eshooper2008-cyber/fpga-wave-generator/src/sin.v

module sin (
    input wire [12:0] INPUT,      
    output reg [9:0] OUTPUT
);

initial OUTPUT = 10'b0000000000;  
reg [9:0] memory [0:8192];

initial begin
    memory[0] = 10'h200; memory[1] = 10'h200; memory[2] = 10'h201; memory[3] = 10'h201; memory[4] = 10'h202; memory[5] = 10'h202; memory[6] = 10'h202; memory[7] = 10'h203; memory[8] = 10'h203; memory[9] = 10'h204;
    memory[10] = 10'h204; memory[11] = 10'h204; memory[12] = 10'h205; memory[13] = 10'h205; memory[14] = 10'h205; memory[15] = 10'h206; memory[16] = 10'h206; memory[17] = 10'h207; memory[18] = 10'h207; memory[19] = 10'h207;
    memory[20] = 10'h208; memory[21] = 10'h208; memory[22] = 10'h209; memory[23] = 10'h209; memory[24] = 10'h209; memory[25] = 10'h20a; memory[26] = 10'h20a; memory[27] = 10'h20b; memory[28] = 10'h20b; memory[29] = 10'h20b;
    memory[30] = 10'h20c; memory[31] = 10'h20c; memory[32] = 10'h20d; memory[33] = 10'h20d; memory[34] = 10'h20d; memory[35] = 10'h20e; memory[36] = 10'h20e; memory[37] = 10'h20f; memory[38] = 10'h20f; memory[39] = 10'h20f;
    memory[40] = 10'h210; memory[41] = 10'h210; memory[42] = 10'h210; memory[43] = 10'h211; memory[44] = 10'h211; memory[45] = 10'h212; memory[46] = 10'h212; memory[47] = 10'h212; memory[48] = 10'h213; memory[49] = 10'h213;
    memory[50] = 10'h214; memory[51] = 10'h214; memory[52] = 10'h214; memory[53] = 10'h215; memory[54] = 10'h215; memory[55] = 10'h216; memory[56] = 10'h216; memory[57] = 10'h216; memory[58] = 10'h217; memory[59] = 10'h217;
    memory[60] = 10'h218; memory[61] = 10'h218; memory[62] = 10'h218; memory[63] = 10'h219; memory[64] = 10'h219; memory[65] = 10'h21a; memory[66] = 10'h21a; memory[67] = 10'h21a; memory[68] = 10'h21b; memory[69] = 10'h21b;
    memory[70] = 10'h21b; memory[71] = 10'h21c; memory[72] = 10'h21c; memory[73] = 10'h21d; memory[74] = 10'h21d; memory[75] = 10'h21d; memory[76] = 10'h21e; memory[77] = 10'h21e; memory[78] = 10'h21f; memory[79] = 10'h21f;
    memory[80] = 10'h21f; memory[81] = 10'h220; memory[82] = 10'h220; memory[83] = 10'h221; memory[84] = 10'h221; memory[85] = 10'h221; memory[86] = 10'h222; memory[87] = 10'h222; memory[88] = 10'h223; memory[89] = 10'h223;
    memory[90] = 10'h223; memory[91] = 10'h224; memory[92] = 10'h224; memory[93] = 10'h224; memory[94] = 10'h225; memory[95] = 10'h225; memory[96] = 10'h226; memory[97] = 10'h226; memory[98] = 10'h226; memory[99] = 10'h227;
    memory[100] = 10'h227; memory[101] = 10'h228; memory[102] = 10'h228; memory[103] = 10'h228; memory[104] = 10'h229; memory[105] = 10'h229; memory[106] = 10'h22a; memory[107] = 10'h22a; memory[108] = 10'h22a; memory[109] = 10'h22b;
    memory[110] = 10'h22b; memory[111] = 10'h22c; memory[112] = 10'h22c; memory[113] = 10'h22c; memory[114] = 10'h22d; memory[115] = 10'h22d; memory[116] = 10'h22d; memory[117] = 10'h22e; memory[118] = 10'h22e; memory[119] = 10'h22f;
    memory[120] = 10'h22f; memory[121] = 10'h22f; memory[122] = 10'h230; memory[123] = 10'h230; memory[124] = 10'h231; memory[125] = 10'h231; memory[126] = 10'h231; memory[127] = 10'h232; memory[128] = 10'h232; memory[129] = 10'h233;
    memory[130] = 10'h233; memory[131] = 10'h233; memory[132] = 10'h234; memory[133] = 10'h234; memory[134] = 10'h235; memory[135] = 10'h235; memory[136] = 10'h235; memory[137] = 10'h236; memory[138] = 10'h236; memory[139] = 10'h236;
    memory[140] = 10'h237; memory[141] = 10'h237; memory[142] = 10'h238; memory[143] = 10'h238; memory[144] = 10'h238; memory[145] = 10'h239; memory[146] = 10'h239; memory[147] = 10'h23a; memory[148] = 10'h23a; memory[149] = 10'h23a;
    memory[150] = 10'h23b; memory[151] = 10'h23b; memory[152] = 10'h23c; memory[153] = 10'h23c; memory[154] = 10'h23c; memory[155] = 10'h23d; memory[156] = 10'h23d; memory[157] = 10'h23e; memory[158] = 10'h23e; memory[159] = 10'h23e;
    memory[160] = 10'h23f; memory[161] = 10'h23f; memory[162] = 10'h23f; memory[163] = 10'h240; memory[164] = 10'h240; memory[165] = 10'h241; memory[166] = 10'h241; memory[167] = 10'h241; memory[168] = 10'h242; memory[169] = 10'h242;
    memory[170] = 10'h243; memory[171] = 10'h243; memory[172] = 10'h243; memory[173] = 10'h244; memory[174] = 10'h244; memory[175] = 10'h245; memory[176] = 10'h245; memory[177] = 10'h245; memory[178] = 10'h246; memory[179] = 10'h246;
    memory[180] = 10'h246; memory[181] = 10'h247; memory[182] = 10'h247; memory[183] = 10'h248; memory[184] = 10'h248; memory[185] = 10'h248; memory[186] = 10'h249; memory[187] = 10'h249; memory[188] = 10'h24a; memory[189] = 10'h24a;
    memory[190] = 10'h24a; memory[191] = 10'h24b; memory[192] = 10'h24b; memory[193] = 10'h24c; memory[194] = 10'h24c; memory[195] = 10'h24c; memory[196] = 10'h24d; memory[197] = 10'h24d; memory[198] = 10'h24d; memory[199] = 10'h24e;
    memory[200] = 10'h24e; memory[201] = 10'h24f; memory[202] = 10'h24f; memory[203] = 10'h24f; memory[204] = 10'h250; memory[205] = 10'h250; memory[206] = 10'h251; memory[207] = 10'h251; memory[208] = 10'h251; memory[209] = 10'h252;
    memory[210] = 10'h252; memory[211] = 10'h252; memory[212] = 10'h253; memory[213] = 10'h253; memory[214] = 10'h254; memory[215] = 10'h254; memory[216] = 10'h254; memory[217] = 10'h255; memory[218] = 10'h255; memory[219] = 10'h256;
    memory[220] = 10'h256; memory[221] = 10'h256; memory[222] = 10'h257; memory[223] = 10'h257; memory[224] = 10'h258; memory[225] = 10'h258; memory[226] = 10'h258; memory[227] = 10'h259; memory[228] = 10'h259; memory[229] = 10'h259;
    memory[230] = 10'h25a; memory[231] = 10'h25a; memory[232] = 10'h25b; memory[233] = 10'h25b; memory[234] = 10'h25b; memory[235] = 10'h25c; memory[236] = 10'h25c; memory[237] = 10'h25d; memory[238] = 10'h25d; memory[239] = 10'h25d;
    memory[240] = 10'h25e; memory[241] = 10'h25e; memory[242] = 10'h25e; memory[243] = 10'h25f; memory[244] = 10'h25f; memory[245] = 10'h260; memory[246] = 10'h260; memory[247] = 10'h260; memory[248] = 10'h261; memory[249] = 10'h261;
    memory[250] = 10'h262; memory[251] = 10'h262; memory[252] = 10'h262; memory[253] = 10'h263; memory[254] = 10'h263; memory[255] = 10'h264; memory[256] = 10'h264; memory[257] = 10'h264; memory[258] = 10'h265; memory[259] = 10'h265;
    memory[260] = 10'h265; memory[261] = 10'h266; memory[262] = 10'h266; memory[263] = 10'h267; memory[264] = 10'h267; memory[265] = 10'h267; memory[266] = 10'h268; memory[267] = 10'h268; memory[268] = 10'h269; memory[269] = 10'h269;
    memory[270] = 10'h269; memory[271] = 10'h26a; memory[272] = 10'h26a; memory[273] = 10'h26a; memory[274] = 10'h26b; memory[275] = 10'h26b; memory[276] = 10'h26c; memory[277] = 10'h26c; memory[278] = 10'h26c; memory[279] = 10'h26d;
    memory[280] = 10'h26d; memory[281] = 10'h26d; memory[282] = 10'h26e; memory[283] = 10'h26e; memory[284] = 10'h26f; memory[285] = 10'h26f; memory[286] = 10'h26f; memory[287] = 10'h270; memory[288] = 10'h270; memory[289] = 10'h271;
    memory[290] = 10'h271; memory[291] = 10'h271; memory[292] = 10'h272; memory[293] = 10'h272; memory[294] = 10'h272; memory[295] = 10'h273; memory[296] = 10'h273; memory[297] = 10'h274; memory[298] = 10'h274; memory[299] = 10'h274;
    memory[300] = 10'h275; memory[301] = 10'h275; memory[302] = 10'h276; memory[303] = 10'h276; memory[304] = 10'h276; memory[305] = 10'h277; memory[306] = 10'h277; memory[307] = 10'h277; memory[308] = 10'h278; memory[309] = 10'h278;
    memory[310] = 10'h279; memory[311] = 10'h279; memory[312] = 10'h279; memory[313] = 10'h27a; memory[314] = 10'h27a; memory[315] = 10'h27b; memory[316] = 10'h27b; memory[317] = 10'h27b; memory[318] = 10'h27c; memory[319] = 10'h27c;
    memory[320] = 10'h27c; memory[321] = 10'h27d; memory[322] = 10'h27d; memory[323] = 10'h27e; memory[324] = 10'h27e; memory[325] = 10'h27e; memory[326] = 10'h27f; memory[327] = 10'h27f; memory[328] = 10'h27f; memory[329] = 10'h280;
    memory[330] = 10'h280; memory[331] = 10'h281; memory[332] = 10'h281; memory[333] = 10'h281; memory[334] = 10'h282; memory[335] = 10'h282; memory[336] = 10'h282; memory[337] = 10'h283; memory[338] = 10'h283; memory[339] = 10'h284;
    memory[340] = 10'h284; memory[341] = 10'h284; memory[342] = 10'h285; memory[343] = 10'h285; memory[344] = 10'h286; memory[345] = 10'h286; memory[346] = 10'h286; memory[347] = 10'h287; memory[348] = 10'h287; memory[349] = 10'h287;
    memory[350] = 10'h288; memory[351] = 10'h288; memory[352] = 10'h289; memory[353] = 10'h289; memory[354] = 10'h289; memory[355] = 10'h28a; memory[356] = 10'h28a; memory[357] = 10'h28a; memory[358] = 10'h28b; memory[359] = 10'h28b;
    memory[360] = 10'h28c; memory[361] = 10'h28c; memory[362] = 10'h28c; memory[363] = 10'h28d; memory[364] = 10'h28d; memory[365] = 10'h28d; memory[366] = 10'h28e; memory[367] = 10'h28e; memory[368] = 10'h28f; memory[369] = 10'h28f;
    memory[370] = 10'h28f; memory[371] = 10'h290; memory[372] = 10'h290; memory[373] = 10'h290; memory[374] = 10'h291; memory[375] = 10'h291; memory[376] = 10'h292; memory[377] = 10'h292; memory[378] = 10'h292; memory[379] = 10'h293;
    memory[380] = 10'h293; memory[381] = 10'h293; memory[382] = 10'h294; memory[383] = 10'h294; memory[384] = 10'h295; memory[385] = 10'h295; memory[386] = 10'h295; memory[387] = 10'h296; memory[388] = 10'h296; memory[389] = 10'h297;
    memory[390] = 10'h297; memory[391] = 10'h297; memory[392] = 10'h298; memory[393] = 10'h298; memory[394] = 10'h298; memory[395] = 10'h299; memory[396] = 10'h299; memory[397] = 10'h29a; memory[398] = 10'h29a; memory[399] = 10'h29a;
    memory[400] = 10'h29b; memory[401] = 10'h29b; memory[402] = 10'h29b; memory[403] = 10'h29c; memory[404] = 10'h29c; memory[405] = 10'h29c; memory[406] = 10'h29d; memory[407] = 10'h29d; memory[408] = 10'h29e; memory[409] = 10'h29e;
    memory[410] = 10'h29e; memory[411] = 10'h29f; memory[412] = 10'h29f; memory[413] = 10'h29f; memory[414] = 10'h2a0; memory[415] = 10'h2a0; memory[416] = 10'h2a1; memory[417] = 10'h2a1; memory[418] = 10'h2a1; memory[419] = 10'h2a2;
    memory[420] = 10'h2a2; memory[421] = 10'h2a2; memory[422] = 10'h2a3; memory[423] = 10'h2a3; memory[424] = 10'h2a4; memory[425] = 10'h2a4; memory[426] = 10'h2a4; memory[427] = 10'h2a5; memory[428] = 10'h2a5; memory[429] = 10'h2a5;
    memory[430] = 10'h2a6; memory[431] = 10'h2a6; memory[432] = 10'h2a7; memory[433] = 10'h2a7; memory[434] = 10'h2a7; memory[435] = 10'h2a8; memory[436] = 10'h2a8; memory[437] = 10'h2a8; memory[438] = 10'h2a9; memory[439] = 10'h2a9;
    memory[440] = 10'h2aa; memory[441] = 10'h2aa; memory[442] = 10'h2aa; memory[443] = 10'h2ab; memory[444] = 10'h2ab; memory[445] = 10'h2ab; memory[446] = 10'h2ac; memory[447] = 10'h2ac; memory[448] = 10'h2ac; memory[449] = 10'h2ad;
    memory[450] = 10'h2ad; memory[451] = 10'h2ae; memory[452] = 10'h2ae; memory[453] = 10'h2ae; memory[454] = 10'h2af; memory[455] = 10'h2af; memory[456] = 10'h2af; memory[457] = 10'h2b0; memory[458] = 10'h2b0; memory[459] = 10'h2b1;
    memory[460] = 10'h2b1; memory[461] = 10'h2b1; memory[462] = 10'h2b2; memory[463] = 10'h2b2; memory[464] = 10'h2b2; memory[465] = 10'h2b3; memory[466] = 10'h2b3; memory[467] = 10'h2b3; memory[468] = 10'h2b4; memory[469] = 10'h2b4;
    memory[470] = 10'h2b5; memory[471] = 10'h2b5; memory[472] = 10'h2b5; memory[473] = 10'h2b6; memory[474] = 10'h2b6; memory[475] = 10'h2b6; memory[476] = 10'h2b7; memory[477] = 10'h2b7; memory[478] = 10'h2b8; memory[479] = 10'h2b8;
    memory[480] = 10'h2b8; memory[481] = 10'h2b9; memory[482] = 10'h2b9; memory[483] = 10'h2b9; memory[484] = 10'h2ba; memory[485] = 10'h2ba; memory[486] = 10'h2ba; memory[487] = 10'h2bb; memory[488] = 10'h2bb; memory[489] = 10'h2bc;
    memory[490] = 10'h2bc; memory[491] = 10'h2bc; memory[492] = 10'h2bd; memory[493] = 10'h2bd; memory[494] = 10'h2bd; memory[495] = 10'h2be; memory[496] = 10'h2be; memory[497] = 10'h2be; memory[498] = 10'h2bf; memory[499] = 10'h2bf;
    memory[500] = 10'h2c0; memory[501] = 10'h2c0; memory[502] = 10'h2c0; memory[503] = 10'h2c1; memory[504] = 10'h2c1; memory[505] = 10'h2c1; memory[506] = 10'h2c2; memory[507] = 10'h2c2; memory[508] = 10'h2c2; memory[509] = 10'h2c3;
    memory[510] = 10'h2c3; memory[511] = 10'h2c4; memory[512] = 10'h2c4; memory[513] = 10'h2c4; memory[514] = 10'h2c5; memory[515] = 10'h2c5; memory[516] = 10'h2c5; memory[517] = 10'h2c6; memory[518] = 10'h2c6; memory[519] = 10'h2c6;
    memory[520] = 10'h2c7; memory[521] = 10'h2c7; memory[522] = 10'h2c8; memory[523] = 10'h2c8; memory[524] = 10'h2c8; memory[525] = 10'h2c9; memory[526] = 10'h2c9; memory[527] = 10'h2c9; memory[528] = 10'h2ca; memory[529] = 10'h2ca;
    memory[530] = 10'h2ca; memory[531] = 10'h2cb; memory[532] = 10'h2cb; memory[533] = 10'h2cc; memory[534] = 10'h2cc; memory[535] = 10'h2cc; memory[536] = 10'h2cd; memory[537] = 10'h2cd; memory[538] = 10'h2cd; memory[539] = 10'h2ce;
    memory[540] = 10'h2ce; memory[541] = 10'h2ce; memory[542] = 10'h2cf; memory[543] = 10'h2cf; memory[544] = 10'h2cf; memory[545] = 10'h2d0; memory[546] = 10'h2d0; memory[547] = 10'h2d1; memory[548] = 10'h2d1; memory[549] = 10'h2d1;
    memory[550] = 10'h2d2; memory[551] = 10'h2d2; memory[552] = 10'h2d2; memory[553] = 10'h2d3; memory[554] = 10'h2d3; memory[555] = 10'h2d3; memory[556] = 10'h2d4; memory[557] = 10'h2d4; memory[558] = 10'h2d4; memory[559] = 10'h2d5;
    memory[560] = 10'h2d5; memory[561] = 10'h2d6; memory[562] = 10'h2d6; memory[563] = 10'h2d6; memory[564] = 10'h2d7; memory[565] = 10'h2d7; memory[566] = 10'h2d7; memory[567] = 10'h2d8; memory[568] = 10'h2d8; memory[569] = 10'h2d8;
    memory[570] = 10'h2d9; memory[571] = 10'h2d9; memory[572] = 10'h2d9; memory[573] = 10'h2da; memory[574] = 10'h2da; memory[575] = 10'h2db; memory[576] = 10'h2db; memory[577] = 10'h2db; memory[578] = 10'h2dc; memory[579] = 10'h2dc;
    memory[580] = 10'h2dc; memory[581] = 10'h2dd; memory[582] = 10'h2dd; memory[583] = 10'h2dd; memory[584] = 10'h2de; memory[585] = 10'h2de; memory[586] = 10'h2de; memory[587] = 10'h2df; memory[588] = 10'h2df; memory[589] = 10'h2e0;
    memory[590] = 10'h2e0; memory[591] = 10'h2e0; memory[592] = 10'h2e1; memory[593] = 10'h2e1; memory[594] = 10'h2e1; memory[595] = 10'h2e2; memory[596] = 10'h2e2; memory[597] = 10'h2e2; memory[598] = 10'h2e3; memory[599] = 10'h2e3;
    memory[600] = 10'h2e3; memory[601] = 10'h2e4; memory[602] = 10'h2e4; memory[603] = 10'h2e4; memory[604] = 10'h2e5; memory[605] = 10'h2e5; memory[606] = 10'h2e5; memory[607] = 10'h2e6; memory[608] = 10'h2e6; memory[609] = 10'h2e7;
    memory[610] = 10'h2e7; memory[611] = 10'h2e7; memory[612] = 10'h2e8; memory[613] = 10'h2e8; memory[614] = 10'h2e8; memory[615] = 10'h2e9; memory[616] = 10'h2e9; memory[617] = 10'h2e9; memory[618] = 10'h2ea; memory[619] = 10'h2ea;
    memory[620] = 10'h2ea; memory[621] = 10'h2eb; memory[622] = 10'h2eb; memory[623] = 10'h2eb; memory[624] = 10'h2ec; memory[625] = 10'h2ec; memory[626] = 10'h2ec; memory[627] = 10'h2ed; memory[628] = 10'h2ed; memory[629] = 10'h2ee;
    memory[630] = 10'h2ee; memory[631] = 10'h2ee; memory[632] = 10'h2ef; memory[633] = 10'h2ef; memory[634] = 10'h2ef; memory[635] = 10'h2f0; memory[636] = 10'h2f0; memory[637] = 10'h2f0; memory[638] = 10'h2f1; memory[639] = 10'h2f1;
    memory[640] = 10'h2f1; memory[641] = 10'h2f2; memory[642] = 10'h2f2; memory[643] = 10'h2f2; memory[644] = 10'h2f3; memory[645] = 10'h2f3; memory[646] = 10'h2f3; memory[647] = 10'h2f4; memory[648] = 10'h2f4; memory[649] = 10'h2f4;
    memory[650] = 10'h2f5; memory[651] = 10'h2f5; memory[652] = 10'h2f6; memory[653] = 10'h2f6; memory[654] = 10'h2f6; memory[655] = 10'h2f7; memory[656] = 10'h2f7; memory[657] = 10'h2f7; memory[658] = 10'h2f8; memory[659] = 10'h2f8;
    memory[660] = 10'h2f8; memory[661] = 10'h2f9; memory[662] = 10'h2f9; memory[663] = 10'h2f9; memory[664] = 10'h2fa; memory[665] = 10'h2fa; memory[666] = 10'h2fa; memory[667] = 10'h2fb; memory[668] = 10'h2fb; memory[669] = 10'h2fb;
    memory[670] = 10'h2fc; memory[671] = 10'h2fc; memory[672] = 10'h2fc; memory[673] = 10'h2fd; memory[674] = 10'h2fd; memory[675] = 10'h2fd; memory[676] = 10'h2fe; memory[677] = 10'h2fe; memory[678] = 10'h2fe; memory[679] = 10'h2ff;
    memory[680] = 10'h2ff; memory[681] = 10'h2ff; memory[682] = 10'h300; memory[683] = 10'h300; memory[684] = 10'h300; memory[685] = 10'h301; memory[686] = 10'h301; memory[687] = 10'h301; memory[688] = 10'h302; memory[689] = 10'h302;
    memory[690] = 10'h302; memory[691] = 10'h303; memory[692] = 10'h303; memory[693] = 10'h304; memory[694] = 10'h304; memory[695] = 10'h304; memory[696] = 10'h305; memory[697] = 10'h305; memory[698] = 10'h305; memory[699] = 10'h306;
    memory[700] = 10'h306; memory[701] = 10'h306; memory[702] = 10'h307; memory[703] = 10'h307; memory[704] = 10'h307; memory[705] = 10'h308; memory[706] = 10'h308; memory[707] = 10'h308; memory[708] = 10'h309; memory[709] = 10'h309;
    memory[710] = 10'h309; memory[711] = 10'h30a; memory[712] = 10'h30a; memory[713] = 10'h30a; memory[714] = 10'h30b; memory[715] = 10'h30b; memory[716] = 10'h30b; memory[717] = 10'h30c; memory[718] = 10'h30c; memory[719] = 10'h30c;
    memory[720] = 10'h30d; memory[721] = 10'h30d; memory[722] = 10'h30d; memory[723] = 10'h30e; memory[724] = 10'h30e; memory[725] = 10'h30e; memory[726] = 10'h30f; memory[727] = 10'h30f; memory[728] = 10'h30f; memory[729] = 10'h310;
    memory[730] = 10'h310; memory[731] = 10'h310; memory[732] = 10'h311; memory[733] = 10'h311; memory[734] = 10'h311; memory[735] = 10'h312; memory[736] = 10'h312; memory[737] = 10'h312; memory[738] = 10'h313; memory[739] = 10'h313;
    memory[740] = 10'h313; memory[741] = 10'h314; memory[742] = 10'h314; memory[743] = 10'h314; memory[744] = 10'h315; memory[745] = 10'h315; memory[746] = 10'h315; memory[747] = 10'h316; memory[748] = 10'h316; memory[749] = 10'h316;
    memory[750] = 10'h317; memory[751] = 10'h317; memory[752] = 10'h317; memory[753] = 10'h318; memory[754] = 10'h318; memory[755] = 10'h318; memory[756] = 10'h319; memory[757] = 10'h319; memory[758] = 10'h319; memory[759] = 10'h31a;
    memory[760] = 10'h31a; memory[761] = 10'h31a; memory[762] = 10'h31a; memory[763] = 10'h31b; memory[764] = 10'h31b; memory[765] = 10'h31b; memory[766] = 10'h31c; memory[767] = 10'h31c; memory[768] = 10'h31c; memory[769] = 10'h31d;
    memory[770] = 10'h31d; memory[771] = 10'h31d; memory[772] = 10'h31e; memory[773] = 10'h31e; memory[774] = 10'h31e; memory[775] = 10'h31f; memory[776] = 10'h31f; memory[777] = 10'h31f; memory[778] = 10'h320; memory[779] = 10'h320;
    memory[780] = 10'h320; memory[781] = 10'h321; memory[782] = 10'h321; memory[783] = 10'h321; memory[784] = 10'h322; memory[785] = 10'h322; memory[786] = 10'h322; memory[787] = 10'h323; memory[788] = 10'h323; memory[789] = 10'h323;
    memory[790] = 10'h324; memory[791] = 10'h324; memory[792] = 10'h324; memory[793] = 10'h325; memory[794] = 10'h325; memory[795] = 10'h325; memory[796] = 10'h326; memory[797] = 10'h326; memory[798] = 10'h326; memory[799] = 10'h326;
    memory[800] = 10'h327; memory[801] = 10'h327; memory[802] = 10'h327; memory[803] = 10'h328; memory[804] = 10'h328; memory[805] = 10'h328; memory[806] = 10'h329; memory[807] = 10'h329; memory[808] = 10'h329; memory[809] = 10'h32a;
    memory[810] = 10'h32a; memory[811] = 10'h32a; memory[812] = 10'h32b; memory[813] = 10'h32b; memory[814] = 10'h32b; memory[815] = 10'h32c; memory[816] = 10'h32c; memory[817] = 10'h32c; memory[818] = 10'h32d; memory[819] = 10'h32d;
    memory[820] = 10'h32d; memory[821] = 10'h32e; memory[822] = 10'h32e; memory[823] = 10'h32e; memory[824] = 10'h32e; memory[825] = 10'h32f; memory[826] = 10'h32f; memory[827] = 10'h32f; memory[828] = 10'h330; memory[829] = 10'h330;
    memory[830] = 10'h330; memory[831] = 10'h331; memory[832] = 10'h331; memory[833] = 10'h331; memory[834] = 10'h332; memory[835] = 10'h332; memory[836] = 10'h332; memory[837] = 10'h333; memory[838] = 10'h333; memory[839] = 10'h333;
    memory[840] = 10'h334; memory[841] = 10'h334; memory[842] = 10'h334; memory[843] = 10'h334; memory[844] = 10'h335; memory[845] = 10'h335; memory[846] = 10'h335; memory[847] = 10'h336; memory[848] = 10'h336; memory[849] = 10'h336;
    memory[850] = 10'h337; memory[851] = 10'h337; memory[852] = 10'h337; memory[853] = 10'h338; memory[854] = 10'h338; memory[855] = 10'h338; memory[856] = 10'h339; memory[857] = 10'h339; memory[858] = 10'h339; memory[859] = 10'h339;
    memory[860] = 10'h33a; memory[861] = 10'h33a; memory[862] = 10'h33a; memory[863] = 10'h33b; memory[864] = 10'h33b; memory[865] = 10'h33b; memory[866] = 10'h33c; memory[867] = 10'h33c; memory[868] = 10'h33c; memory[869] = 10'h33d;
    memory[870] = 10'h33d; memory[871] = 10'h33d; memory[872] = 10'h33d; memory[873] = 10'h33e; memory[874] = 10'h33e; memory[875] = 10'h33e; memory[876] = 10'h33f; memory[877] = 10'h33f; memory[878] = 10'h33f; memory[879] = 10'h340;
    memory[880] = 10'h340; memory[881] = 10'h340; memory[882] = 10'h341; memory[883] = 10'h341; memory[884] = 10'h341; memory[885] = 10'h341; memory[886] = 10'h342; memory[887] = 10'h342; memory[888] = 10'h342; memory[889] = 10'h343;
    memory[890] = 10'h343; memory[891] = 10'h343; memory[892] = 10'h344; memory[893] = 10'h344; memory[894] = 10'h344; memory[895] = 10'h345; memory[896] = 10'h345; memory[897] = 10'h345; memory[898] = 10'h345; memory[899] = 10'h346;
    memory[900] = 10'h346; memory[901] = 10'h346; memory[902] = 10'h347; memory[903] = 10'h347; memory[904] = 10'h347; memory[905] = 10'h348; memory[906] = 10'h348; memory[907] = 10'h348; memory[908] = 10'h348; memory[909] = 10'h349;
    memory[910] = 10'h349; memory[911] = 10'h349; memory[912] = 10'h34a; memory[913] = 10'h34a; memory[914] = 10'h34a; memory[915] = 10'h34b; memory[916] = 10'h34b; memory[917] = 10'h34b; memory[918] = 10'h34b; memory[919] = 10'h34c;
    memory[920] = 10'h34c; memory[921] = 10'h34c; memory[922] = 10'h34d; memory[923] = 10'h34d; memory[924] = 10'h34d; memory[925] = 10'h34e; memory[926] = 10'h34e; memory[927] = 10'h34e; memory[928] = 10'h34e; memory[929] = 10'h34f;
    memory[930] = 10'h34f; memory[931] = 10'h34f; memory[932] = 10'h350; memory[933] = 10'h350; memory[934] = 10'h350; memory[935] = 10'h351; memory[936] = 10'h351; memory[937] = 10'h351; memory[938] = 10'h351; memory[939] = 10'h352;
    memory[940] = 10'h352; memory[941] = 10'h352; memory[942] = 10'h353; memory[943] = 10'h353; memory[944] = 10'h353; memory[945] = 10'h353; memory[946] = 10'h354; memory[947] = 10'h354; memory[948] = 10'h354; memory[949] = 10'h355;
    memory[950] = 10'h355; memory[951] = 10'h355; memory[952] = 10'h356; memory[953] = 10'h356; memory[954] = 10'h356; memory[955] = 10'h356; memory[956] = 10'h357; memory[957] = 10'h357; memory[958] = 10'h357; memory[959] = 10'h358;
    memory[960] = 10'h358; memory[961] = 10'h358; memory[962] = 10'h358; memory[963] = 10'h359; memory[964] = 10'h359; memory[965] = 10'h359; memory[966] = 10'h35a; memory[967] = 10'h35a; memory[968] = 10'h35a; memory[969] = 10'h35a;
    memory[970] = 10'h35b; memory[971] = 10'h35b; memory[972] = 10'h35b; memory[973] = 10'h35c; memory[974] = 10'h35c; memory[975] = 10'h35c; memory[976] = 10'h35c; memory[977] = 10'h35d; memory[978] = 10'h35d; memory[979] = 10'h35d;
    memory[980] = 10'h35e; memory[981] = 10'h35e; memory[982] = 10'h35e; memory[983] = 10'h35e; memory[984] = 10'h35f; memory[985] = 10'h35f; memory[986] = 10'h35f; memory[987] = 10'h360; memory[988] = 10'h360; memory[989] = 10'h360;
    memory[990] = 10'h360; memory[991] = 10'h361; memory[992] = 10'h361; memory[993] = 10'h361; memory[994] = 10'h362; memory[995] = 10'h362; memory[996] = 10'h362; memory[997] = 10'h362; memory[998] = 10'h363; memory[999] = 10'h363;
    memory[1000] = 10'h363; memory[1001] = 10'h364; memory[1002] = 10'h364; memory[1003] = 10'h364; memory[1004] = 10'h364; memory[1005] = 10'h365; memory[1006] = 10'h365; memory[1007] = 10'h365; memory[1008] = 10'h366; memory[1009] = 10'h366;
    memory[1010] = 10'h366; memory[1011] = 10'h366; memory[1012] = 10'h367; memory[1013] = 10'h367; memory[1014] = 10'h367; memory[1015] = 10'h368; memory[1016] = 10'h368; memory[1017] = 10'h368; memory[1018] = 10'h368; memory[1019] = 10'h369;
    memory[1020] = 10'h369; memory[1021] = 10'h369; memory[1022] = 10'h369; memory[1023] = 10'h36a; memory[1024] = 10'h36a; memory[1025] = 10'h36a; memory[1026] = 10'h36b; memory[1027] = 10'h36b; memory[1028] = 10'h36b; memory[1029] = 10'h36b;
    memory[1030] = 10'h36c; memory[1031] = 10'h36c; memory[1032] = 10'h36c; memory[1033] = 10'h36d; memory[1034] = 10'h36d; memory[1035] = 10'h36d; memory[1036] = 10'h36d; memory[1037] = 10'h36e; memory[1038] = 10'h36e; memory[1039] = 10'h36e;
    memory[1040] = 10'h36e; memory[1041] = 10'h36f; memory[1042] = 10'h36f; memory[1043] = 10'h36f; memory[1044] = 10'h370; memory[1045] = 10'h370; memory[1046] = 10'h370; memory[1047] = 10'h370; memory[1048] = 10'h371; memory[1049] = 10'h371;
    memory[1050] = 10'h371; memory[1051] = 10'h371; memory[1052] = 10'h372; memory[1053] = 10'h372; memory[1054] = 10'h372; memory[1055] = 10'h373; memory[1056] = 10'h373; memory[1057] = 10'h373; memory[1058] = 10'h373; memory[1059] = 10'h374;
    memory[1060] = 10'h374; memory[1061] = 10'h374; memory[1062] = 10'h374; memory[1063] = 10'h375; memory[1064] = 10'h375; memory[1065] = 10'h375; memory[1066] = 10'h376; memory[1067] = 10'h376; memory[1068] = 10'h376; memory[1069] = 10'h376;
    memory[1070] = 10'h377; memory[1071] = 10'h377; memory[1072] = 10'h377; memory[1073] = 10'h377; memory[1074] = 10'h378; memory[1075] = 10'h378; memory[1076] = 10'h378; memory[1077] = 10'h378; memory[1078] = 10'h379; memory[1079] = 10'h379;
    memory[1080] = 10'h379; memory[1081] = 10'h37a; memory[1082] = 10'h37a; memory[1083] = 10'h37a; memory[1084] = 10'h37a; memory[1085] = 10'h37b; memory[1086] = 10'h37b; memory[1087] = 10'h37b; memory[1088] = 10'h37b; memory[1089] = 10'h37c;
    memory[1090] = 10'h37c; memory[1091] = 10'h37c; memory[1092] = 10'h37c; memory[1093] = 10'h37d; memory[1094] = 10'h37d; memory[1095] = 10'h37d; memory[1096] = 10'h37d; memory[1097] = 10'h37e; memory[1098] = 10'h37e; memory[1099] = 10'h37e;
    memory[1100] = 10'h37f; memory[1101] = 10'h37f; memory[1102] = 10'h37f; memory[1103] = 10'h37f; memory[1104] = 10'h380; memory[1105] = 10'h380; memory[1106] = 10'h380; memory[1107] = 10'h380; memory[1108] = 10'h381; memory[1109] = 10'h381;
    memory[1110] = 10'h381; memory[1111] = 10'h381; memory[1112] = 10'h382; memory[1113] = 10'h382; memory[1114] = 10'h382; memory[1115] = 10'h382; memory[1116] = 10'h383; memory[1117] = 10'h383; memory[1118] = 10'h383; memory[1119] = 10'h383;
    memory[1120] = 10'h384; memory[1121] = 10'h384; memory[1122] = 10'h384; memory[1123] = 10'h384; memory[1124] = 10'h385; memory[1125] = 10'h385; memory[1126] = 10'h385; memory[1127] = 10'h385; memory[1128] = 10'h386; memory[1129] = 10'h386;
    memory[1130] = 10'h386; memory[1131] = 10'h386; memory[1132] = 10'h387; memory[1133] = 10'h387; memory[1134] = 10'h387; memory[1135] = 10'h388; memory[1136] = 10'h388; memory[1137] = 10'h388; memory[1138] = 10'h388; memory[1139] = 10'h389;
    memory[1140] = 10'h389; memory[1141] = 10'h389; memory[1142] = 10'h389; memory[1143] = 10'h38a; memory[1144] = 10'h38a; memory[1145] = 10'h38a; memory[1146] = 10'h38a; memory[1147] = 10'h38b; memory[1148] = 10'h38b; memory[1149] = 10'h38b;
    memory[1150] = 10'h38b; memory[1151] = 10'h38c; memory[1152] = 10'h38c; memory[1153] = 10'h38c; memory[1154] = 10'h38c; memory[1155] = 10'h38d; memory[1156] = 10'h38d; memory[1157] = 10'h38d; memory[1158] = 10'h38d; memory[1159] = 10'h38e;
    memory[1160] = 10'h38e; memory[1161] = 10'h38e; memory[1162] = 10'h38e; memory[1163] = 10'h38f; memory[1164] = 10'h38f; memory[1165] = 10'h38f; memory[1166] = 10'h38f; memory[1167] = 10'h38f; memory[1168] = 10'h390; memory[1169] = 10'h390;
    memory[1170] = 10'h390; memory[1171] = 10'h390; memory[1172] = 10'h391; memory[1173] = 10'h391; memory[1174] = 10'h391; memory[1175] = 10'h391; memory[1176] = 10'h392; memory[1177] = 10'h392; memory[1178] = 10'h392; memory[1179] = 10'h392;
    memory[1180] = 10'h393; memory[1181] = 10'h393; memory[1182] = 10'h393; memory[1183] = 10'h393; memory[1184] = 10'h394; memory[1185] = 10'h394; memory[1186] = 10'h394; memory[1187] = 10'h394; memory[1188] = 10'h395; memory[1189] = 10'h395;
    memory[1190] = 10'h395; memory[1191] = 10'h395; memory[1192] = 10'h396; memory[1193] = 10'h396; memory[1194] = 10'h396; memory[1195] = 10'h396; memory[1196] = 10'h397; memory[1197] = 10'h397; memory[1198] = 10'h397; memory[1199] = 10'h397;
    memory[1200] = 10'h397; memory[1201] = 10'h398; memory[1202] = 10'h398; memory[1203] = 10'h398; memory[1204] = 10'h398; memory[1205] = 10'h399; memory[1206] = 10'h399; memory[1207] = 10'h399; memory[1208] = 10'h399; memory[1209] = 10'h39a;
    memory[1210] = 10'h39a; memory[1211] = 10'h39a; memory[1212] = 10'h39a; memory[1213] = 10'h39b; memory[1214] = 10'h39b; memory[1215] = 10'h39b; memory[1216] = 10'h39b; memory[1217] = 10'h39b; memory[1218] = 10'h39c; memory[1219] = 10'h39c;
    memory[1220] = 10'h39c; memory[1221] = 10'h39c; memory[1222] = 10'h39d; memory[1223] = 10'h39d; memory[1224] = 10'h39d; memory[1225] = 10'h39d; memory[1226] = 10'h39e; memory[1227] = 10'h39e; memory[1228] = 10'h39e; memory[1229] = 10'h39e;
    memory[1230] = 10'h39e; memory[1231] = 10'h39f; memory[1232] = 10'h39f; memory[1233] = 10'h39f; memory[1234] = 10'h39f; memory[1235] = 10'h3a0; memory[1236] = 10'h3a0; memory[1237] = 10'h3a0; memory[1238] = 10'h3a0; memory[1239] = 10'h3a1;
    memory[1240] = 10'h3a1; memory[1241] = 10'h3a1; memory[1242] = 10'h3a1; memory[1243] = 10'h3a1; memory[1244] = 10'h3a2; memory[1245] = 10'h3a2; memory[1246] = 10'h3a2; memory[1247] = 10'h3a2; memory[1248] = 10'h3a3; memory[1249] = 10'h3a3;
    memory[1250] = 10'h3a3; memory[1251] = 10'h3a3; memory[1252] = 10'h3a4; memory[1253] = 10'h3a4; memory[1254] = 10'h3a4; memory[1255] = 10'h3a4; memory[1256] = 10'h3a4; memory[1257] = 10'h3a5; memory[1258] = 10'h3a5; memory[1259] = 10'h3a5;
    memory[1260] = 10'h3a5; memory[1261] = 10'h3a6; memory[1262] = 10'h3a6; memory[1263] = 10'h3a6; memory[1264] = 10'h3a6; memory[1265] = 10'h3a6; memory[1266] = 10'h3a7; memory[1267] = 10'h3a7; memory[1268] = 10'h3a7; memory[1269] = 10'h3a7;
    memory[1270] = 10'h3a8; memory[1271] = 10'h3a8; memory[1272] = 10'h3a8; memory[1273] = 10'h3a8; memory[1274] = 10'h3a8; memory[1275] = 10'h3a9; memory[1276] = 10'h3a9; memory[1277] = 10'h3a9; memory[1278] = 10'h3a9; memory[1279] = 10'h3a9;
    memory[1280] = 10'h3aa; memory[1281] = 10'h3aa; memory[1282] = 10'h3aa; memory[1283] = 10'h3aa; memory[1284] = 10'h3ab; memory[1285] = 10'h3ab; memory[1286] = 10'h3ab; memory[1287] = 10'h3ab; memory[1288] = 10'h3ab; memory[1289] = 10'h3ac;
    memory[1290] = 10'h3ac; memory[1291] = 10'h3ac; memory[1292] = 10'h3ac; memory[1293] = 10'h3ad; memory[1294] = 10'h3ad; memory[1295] = 10'h3ad; memory[1296] = 10'h3ad; memory[1297] = 10'h3ad; memory[1298] = 10'h3ae; memory[1299] = 10'h3ae;
    memory[1300] = 10'h3ae; memory[1301] = 10'h3ae; memory[1302] = 10'h3ae; memory[1303] = 10'h3af; memory[1304] = 10'h3af; memory[1305] = 10'h3af; memory[1306] = 10'h3af; memory[1307] = 10'h3b0; memory[1308] = 10'h3b0; memory[1309] = 10'h3b0;
    memory[1310] = 10'h3b0; memory[1311] = 10'h3b0; memory[1312] = 10'h3b1; memory[1313] = 10'h3b1; memory[1314] = 10'h3b1; memory[1315] = 10'h3b1; memory[1316] = 10'h3b1; memory[1317] = 10'h3b2; memory[1318] = 10'h3b2; memory[1319] = 10'h3b2;
    memory[1320] = 10'h3b2; memory[1321] = 10'h3b2; memory[1322] = 10'h3b3; memory[1323] = 10'h3b3; memory[1324] = 10'h3b3; memory[1325] = 10'h3b3; memory[1326] = 10'h3b3; memory[1327] = 10'h3b4; memory[1328] = 10'h3b4; memory[1329] = 10'h3b4;
    memory[1330] = 10'h3b4; memory[1331] = 10'h3b5; memory[1332] = 10'h3b5; memory[1333] = 10'h3b5; memory[1334] = 10'h3b5; memory[1335] = 10'h3b5; memory[1336] = 10'h3b6; memory[1337] = 10'h3b6; memory[1338] = 10'h3b6; memory[1339] = 10'h3b6;
    memory[1340] = 10'h3b6; memory[1341] = 10'h3b7; memory[1342] = 10'h3b7; memory[1343] = 10'h3b7; memory[1344] = 10'h3b7; memory[1345] = 10'h3b7; memory[1346] = 10'h3b8; memory[1347] = 10'h3b8; memory[1348] = 10'h3b8; memory[1349] = 10'h3b8;
    memory[1350] = 10'h3b8; memory[1351] = 10'h3b9; memory[1352] = 10'h3b9; memory[1353] = 10'h3b9; memory[1354] = 10'h3b9; memory[1355] = 10'h3b9; memory[1356] = 10'h3ba; memory[1357] = 10'h3ba; memory[1358] = 10'h3ba; memory[1359] = 10'h3ba;
    memory[1360] = 10'h3ba; memory[1361] = 10'h3bb; memory[1362] = 10'h3bb; memory[1363] = 10'h3bb; memory[1364] = 10'h3bb; memory[1365] = 10'h3bb; memory[1366] = 10'h3bc; memory[1367] = 10'h3bc; memory[1368] = 10'h3bc; memory[1369] = 10'h3bc;
    memory[1370] = 10'h3bc; memory[1371] = 10'h3bd; memory[1372] = 10'h3bd; memory[1373] = 10'h3bd; memory[1374] = 10'h3bd; memory[1375] = 10'h3bd; memory[1376] = 10'h3bd; memory[1377] = 10'h3be; memory[1378] = 10'h3be; memory[1379] = 10'h3be;
    memory[1380] = 10'h3be; memory[1381] = 10'h3be; memory[1382] = 10'h3bf; memory[1383] = 10'h3bf; memory[1384] = 10'h3bf; memory[1385] = 10'h3bf; memory[1386] = 10'h3bf; memory[1387] = 10'h3c0; memory[1388] = 10'h3c0; memory[1389] = 10'h3c0;
    memory[1390] = 10'h3c0; memory[1391] = 10'h3c0; memory[1392] = 10'h3c1; memory[1393] = 10'h3c1; memory[1394] = 10'h3c1; memory[1395] = 10'h3c1; memory[1396] = 10'h3c1; memory[1397] = 10'h3c1; memory[1398] = 10'h3c2; memory[1399] = 10'h3c2;
    memory[1400] = 10'h3c2; memory[1401] = 10'h3c2; memory[1402] = 10'h3c2; memory[1403] = 10'h3c3; memory[1404] = 10'h3c3; memory[1405] = 10'h3c3; memory[1406] = 10'h3c3; memory[1407] = 10'h3c3; memory[1408] = 10'h3c4; memory[1409] = 10'h3c4;
    memory[1410] = 10'h3c4; memory[1411] = 10'h3c4; memory[1412] = 10'h3c4; memory[1413] = 10'h3c4; memory[1414] = 10'h3c5; memory[1415] = 10'h3c5; memory[1416] = 10'h3c5; memory[1417] = 10'h3c5; memory[1418] = 10'h3c5; memory[1419] = 10'h3c6;
    memory[1420] = 10'h3c6; memory[1421] = 10'h3c6; memory[1422] = 10'h3c6; memory[1423] = 10'h3c6; memory[1424] = 10'h3c6; memory[1425] = 10'h3c7; memory[1426] = 10'h3c7; memory[1427] = 10'h3c7; memory[1428] = 10'h3c7; memory[1429] = 10'h3c7;
    memory[1430] = 10'h3c8; memory[1431] = 10'h3c8; memory[1432] = 10'h3c8; memory[1433] = 10'h3c8; memory[1434] = 10'h3c8; memory[1435] = 10'h3c8; memory[1436] = 10'h3c9; memory[1437] = 10'h3c9; memory[1438] = 10'h3c9; memory[1439] = 10'h3c9;
    memory[1440] = 10'h3c9; memory[1441] = 10'h3ca; memory[1442] = 10'h3ca; memory[1443] = 10'h3ca; memory[1444] = 10'h3ca; memory[1445] = 10'h3ca; memory[1446] = 10'h3ca; memory[1447] = 10'h3cb; memory[1448] = 10'h3cb; memory[1449] = 10'h3cb;
    memory[1450] = 10'h3cb; memory[1451] = 10'h3cb; memory[1452] = 10'h3cb; memory[1453] = 10'h3cc; memory[1454] = 10'h3cc; memory[1455] = 10'h3cc; memory[1456] = 10'h3cc; memory[1457] = 10'h3cc; memory[1458] = 10'h3cc; memory[1459] = 10'h3cd;
    memory[1460] = 10'h3cd; memory[1461] = 10'h3cd; memory[1462] = 10'h3cd; memory[1463] = 10'h3cd; memory[1464] = 10'h3cd; memory[1465] = 10'h3ce; memory[1466] = 10'h3ce; memory[1467] = 10'h3ce; memory[1468] = 10'h3ce; memory[1469] = 10'h3ce;
    memory[1470] = 10'h3cf; memory[1471] = 10'h3cf; memory[1472] = 10'h3cf; memory[1473] = 10'h3cf; memory[1474] = 10'h3cf; memory[1475] = 10'h3cf; memory[1476] = 10'h3d0; memory[1477] = 10'h3d0; memory[1478] = 10'h3d0; memory[1479] = 10'h3d0;
    memory[1480] = 10'h3d0; memory[1481] = 10'h3d0; memory[1482] = 10'h3d1; memory[1483] = 10'h3d1; memory[1484] = 10'h3d1; memory[1485] = 10'h3d1; memory[1486] = 10'h3d1; memory[1487] = 10'h3d1; memory[1488] = 10'h3d1; memory[1489] = 10'h3d2;
    memory[1490] = 10'h3d2; memory[1491] = 10'h3d2; memory[1492] = 10'h3d2; memory[1493] = 10'h3d2; memory[1494] = 10'h3d2; memory[1495] = 10'h3d3; memory[1496] = 10'h3d3; memory[1497] = 10'h3d3; memory[1498] = 10'h3d3; memory[1499] = 10'h3d3;
    memory[1500] = 10'h3d3; memory[1501] = 10'h3d4; memory[1502] = 10'h3d4; memory[1503] = 10'h3d4; memory[1504] = 10'h3d4; memory[1505] = 10'h3d4; memory[1506] = 10'h3d4; memory[1507] = 10'h3d5; memory[1508] = 10'h3d5; memory[1509] = 10'h3d5;
    memory[1510] = 10'h3d5; memory[1511] = 10'h3d5; memory[1512] = 10'h3d5; memory[1513] = 10'h3d5; memory[1514] = 10'h3d6; memory[1515] = 10'h3d6; memory[1516] = 10'h3d6; memory[1517] = 10'h3d6; memory[1518] = 10'h3d6; memory[1519] = 10'h3d6;
    memory[1520] = 10'h3d7; memory[1521] = 10'h3d7; memory[1522] = 10'h3d7; memory[1523] = 10'h3d7; memory[1524] = 10'h3d7; memory[1525] = 10'h3d7; memory[1526] = 10'h3d8; memory[1527] = 10'h3d8; memory[1528] = 10'h3d8; memory[1529] = 10'h3d8;
    memory[1530] = 10'h3d8; memory[1531] = 10'h3d8; memory[1532] = 10'h3d8; memory[1533] = 10'h3d9; memory[1534] = 10'h3d9; memory[1535] = 10'h3d9; memory[1536] = 10'h3d9; memory[1537] = 10'h3d9; memory[1538] = 10'h3d9; memory[1539] = 10'h3d9;
    memory[1540] = 10'h3da; memory[1541] = 10'h3da; memory[1542] = 10'h3da; memory[1543] = 10'h3da; memory[1544] = 10'h3da; memory[1545] = 10'h3da; memory[1546] = 10'h3db; memory[1547] = 10'h3db; memory[1548] = 10'h3db; memory[1549] = 10'h3db;
    memory[1550] = 10'h3db; memory[1551] = 10'h3db; memory[1552] = 10'h3db; memory[1553] = 10'h3dc; memory[1554] = 10'h3dc; memory[1555] = 10'h3dc; memory[1556] = 10'h3dc; memory[1557] = 10'h3dc; memory[1558] = 10'h3dc; memory[1559] = 10'h3dc;
    memory[1560] = 10'h3dd; memory[1561] = 10'h3dd; memory[1562] = 10'h3dd; memory[1563] = 10'h3dd; memory[1564] = 10'h3dd; memory[1565] = 10'h3dd; memory[1566] = 10'h3dd; memory[1567] = 10'h3de; memory[1568] = 10'h3de; memory[1569] = 10'h3de;
    memory[1570] = 10'h3de; memory[1571] = 10'h3de; memory[1572] = 10'h3de; memory[1573] = 10'h3de; memory[1574] = 10'h3df; memory[1575] = 10'h3df; memory[1576] = 10'h3df; memory[1577] = 10'h3df; memory[1578] = 10'h3df; memory[1579] = 10'h3df;
    memory[1580] = 10'h3df; memory[1581] = 10'h3e0; memory[1582] = 10'h3e0; memory[1583] = 10'h3e0; memory[1584] = 10'h3e0; memory[1585] = 10'h3e0; memory[1586] = 10'h3e0; memory[1587] = 10'h3e0; memory[1588] = 10'h3e0; memory[1589] = 10'h3e1;
    memory[1590] = 10'h3e1; memory[1591] = 10'h3e1; memory[1592] = 10'h3e1; memory[1593] = 10'h3e1; memory[1594] = 10'h3e1; memory[1595] = 10'h3e1; memory[1596] = 10'h3e2; memory[1597] = 10'h3e2; memory[1598] = 10'h3e2; memory[1599] = 10'h3e2;
    memory[1600] = 10'h3e2; memory[1601] = 10'h3e2; memory[1602] = 10'h3e2; memory[1603] = 10'h3e2; memory[1604] = 10'h3e3; memory[1605] = 10'h3e3; memory[1606] = 10'h3e3; memory[1607] = 10'h3e3; memory[1608] = 10'h3e3; memory[1609] = 10'h3e3;
    memory[1610] = 10'h3e3; memory[1611] = 10'h3e4; memory[1612] = 10'h3e4; memory[1613] = 10'h3e4; memory[1614] = 10'h3e4; memory[1615] = 10'h3e4; memory[1616] = 10'h3e4; memory[1617] = 10'h3e4; memory[1618] = 10'h3e4; memory[1619] = 10'h3e5;
    memory[1620] = 10'h3e5; memory[1621] = 10'h3e5; memory[1622] = 10'h3e5; memory[1623] = 10'h3e5; memory[1624] = 10'h3e5; memory[1625] = 10'h3e5; memory[1626] = 10'h3e5; memory[1627] = 10'h3e6; memory[1628] = 10'h3e6; memory[1629] = 10'h3e6;
    memory[1630] = 10'h3e6; memory[1631] = 10'h3e6; memory[1632] = 10'h3e6; memory[1633] = 10'h3e6; memory[1634] = 10'h3e6; memory[1635] = 10'h3e7; memory[1636] = 10'h3e7; memory[1637] = 10'h3e7; memory[1638] = 10'h3e7; memory[1639] = 10'h3e7;
    memory[1640] = 10'h3e7; memory[1641] = 10'h3e7; memory[1642] = 10'h3e7; memory[1643] = 10'h3e7; memory[1644] = 10'h3e8; memory[1645] = 10'h3e8; memory[1646] = 10'h3e8; memory[1647] = 10'h3e8; memory[1648] = 10'h3e8; memory[1649] = 10'h3e8;
    memory[1650] = 10'h3e8; memory[1651] = 10'h3e8; memory[1652] = 10'h3e9; memory[1653] = 10'h3e9; memory[1654] = 10'h3e9; memory[1655] = 10'h3e9; memory[1656] = 10'h3e9; memory[1657] = 10'h3e9; memory[1658] = 10'h3e9; memory[1659] = 10'h3e9;
    memory[1660] = 10'h3e9; memory[1661] = 10'h3ea; memory[1662] = 10'h3ea; memory[1663] = 10'h3ea; memory[1664] = 10'h3ea; memory[1665] = 10'h3ea; memory[1666] = 10'h3ea; memory[1667] = 10'h3ea; memory[1668] = 10'h3ea; memory[1669] = 10'h3eb;
    memory[1670] = 10'h3eb; memory[1671] = 10'h3eb; memory[1672] = 10'h3eb; memory[1673] = 10'h3eb; memory[1674] = 10'h3eb; memory[1675] = 10'h3eb; memory[1676] = 10'h3eb; memory[1677] = 10'h3eb; memory[1678] = 10'h3ec; memory[1679] = 10'h3ec;
    memory[1680] = 10'h3ec; memory[1681] = 10'h3ec; memory[1682] = 10'h3ec; memory[1683] = 10'h3ec; memory[1684] = 10'h3ec; memory[1685] = 10'h3ec; memory[1686] = 10'h3ec; memory[1687] = 10'h3ec; memory[1688] = 10'h3ed; memory[1689] = 10'h3ed;
    memory[1690] = 10'h3ed; memory[1691] = 10'h3ed; memory[1692] = 10'h3ed; memory[1693] = 10'h3ed; memory[1694] = 10'h3ed; memory[1695] = 10'h3ed; memory[1696] = 10'h3ed; memory[1697] = 10'h3ee; memory[1698] = 10'h3ee; memory[1699] = 10'h3ee;
    memory[1700] = 10'h3ee; memory[1701] = 10'h3ee; memory[1702] = 10'h3ee; memory[1703] = 10'h3ee; memory[1704] = 10'h3ee; memory[1705] = 10'h3ee; memory[1706] = 10'h3ee; memory[1707] = 10'h3ef; memory[1708] = 10'h3ef; memory[1709] = 10'h3ef;
    memory[1710] = 10'h3ef; memory[1711] = 10'h3ef; memory[1712] = 10'h3ef; memory[1713] = 10'h3ef; memory[1714] = 10'h3ef; memory[1715] = 10'h3ef; memory[1716] = 10'h3ef; memory[1717] = 10'h3f0; memory[1718] = 10'h3f0; memory[1719] = 10'h3f0;
    memory[1720] = 10'h3f0; memory[1721] = 10'h3f0; memory[1722] = 10'h3f0; memory[1723] = 10'h3f0; memory[1724] = 10'h3f0; memory[1725] = 10'h3f0; memory[1726] = 10'h3f0; memory[1727] = 10'h3f1; memory[1728] = 10'h3f1; memory[1729] = 10'h3f1;
    memory[1730] = 10'h3f1; memory[1731] = 10'h3f1; memory[1732] = 10'h3f1; memory[1733] = 10'h3f1; memory[1734] = 10'h3f1; memory[1735] = 10'h3f1; memory[1736] = 10'h3f1; memory[1737] = 10'h3f2; memory[1738] = 10'h3f2; memory[1739] = 10'h3f2;
    memory[1740] = 10'h3f2; memory[1741] = 10'h3f2; memory[1742] = 10'h3f2; memory[1743] = 10'h3f2; memory[1744] = 10'h3f2; memory[1745] = 10'h3f2; memory[1746] = 10'h3f2; memory[1747] = 10'h3f2; memory[1748] = 10'h3f3; memory[1749] = 10'h3f3;
    memory[1750] = 10'h3f3; memory[1751] = 10'h3f3; memory[1752] = 10'h3f3; memory[1753] = 10'h3f3; memory[1754] = 10'h3f3; memory[1755] = 10'h3f3; memory[1756] = 10'h3f3; memory[1757] = 10'h3f3; memory[1758] = 10'h3f3; memory[1759] = 10'h3f3;
    memory[1760] = 10'h3f4; memory[1761] = 10'h3f4; memory[1762] = 10'h3f4; memory[1763] = 10'h3f4; memory[1764] = 10'h3f4; memory[1765] = 10'h3f4; memory[1766] = 10'h3f4; memory[1767] = 10'h3f4; memory[1768] = 10'h3f4; memory[1769] = 10'h3f4;
    memory[1770] = 10'h3f4; memory[1771] = 10'h3f4; memory[1772] = 10'h3f5; memory[1773] = 10'h3f5; memory[1774] = 10'h3f5; memory[1775] = 10'h3f5; memory[1776] = 10'h3f5; memory[1777] = 10'h3f5; memory[1778] = 10'h3f5; memory[1779] = 10'h3f5;
    memory[1780] = 10'h3f5; memory[1781] = 10'h3f5; memory[1782] = 10'h3f5; memory[1783] = 10'h3f5; memory[1784] = 10'h3f6; memory[1785] = 10'h3f6; memory[1786] = 10'h3f6; memory[1787] = 10'h3f6; memory[1788] = 10'h3f6; memory[1789] = 10'h3f6;
    memory[1790] = 10'h3f6; memory[1791] = 10'h3f6; memory[1792] = 10'h3f6; memory[1793] = 10'h3f6; memory[1794] = 10'h3f6; memory[1795] = 10'h3f6; memory[1796] = 10'h3f6; memory[1797] = 10'h3f7; memory[1798] = 10'h3f7; memory[1799] = 10'h3f7;
    memory[1800] = 10'h3f7; memory[1801] = 10'h3f7; memory[1802] = 10'h3f7; memory[1803] = 10'h3f7; memory[1804] = 10'h3f7; memory[1805] = 10'h3f7; memory[1806] = 10'h3f7; memory[1807] = 10'h3f7; memory[1808] = 10'h3f7; memory[1809] = 10'h3f7;
    memory[1810] = 10'h3f7; memory[1811] = 10'h3f8; memory[1812] = 10'h3f8; memory[1813] = 10'h3f8; memory[1814] = 10'h3f8; memory[1815] = 10'h3f8; memory[1816] = 10'h3f8; memory[1817] = 10'h3f8; memory[1818] = 10'h3f8; memory[1819] = 10'h3f8;
    memory[1820] = 10'h3f8; memory[1821] = 10'h3f8; memory[1822] = 10'h3f8; memory[1823] = 10'h3f8; memory[1824] = 10'h3f8; memory[1825] = 10'h3f9; memory[1826] = 10'h3f9; memory[1827] = 10'h3f9; memory[1828] = 10'h3f9; memory[1829] = 10'h3f9;
    memory[1830] = 10'h3f9; memory[1831] = 10'h3f9; memory[1832] = 10'h3f9; memory[1833] = 10'h3f9; memory[1834] = 10'h3f9; memory[1835] = 10'h3f9; memory[1836] = 10'h3f9; memory[1837] = 10'h3f9; memory[1838] = 10'h3f9; memory[1839] = 10'h3f9;
    memory[1840] = 10'h3f9; memory[1841] = 10'h3fa; memory[1842] = 10'h3fa; memory[1843] = 10'h3fa; memory[1844] = 10'h3fa; memory[1845] = 10'h3fa; memory[1846] = 10'h3fa; memory[1847] = 10'h3fa; memory[1848] = 10'h3fa; memory[1849] = 10'h3fa;
    memory[1850] = 10'h3fa; memory[1851] = 10'h3fa; memory[1852] = 10'h3fa; memory[1853] = 10'h3fa; memory[1854] = 10'h3fa; memory[1855] = 10'h3fa; memory[1856] = 10'h3fa; memory[1857] = 10'h3fb; memory[1858] = 10'h3fb; memory[1859] = 10'h3fb;
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
    memory[2390] = 10'h3ee; memory[2391] = 10'h3ee; memory[2392] = 10'h3ee; memory[2393] = 10'h3ee; memory[2394] = 10'h3ee; memory[2395] = 10'h3ee; memory[2396] = 10'h3ee; memory[2397] = 10'h3ee; memory[2398] = 10'h3ee; memory[2399] = 10'h3ee;
    memory[2400] = 10'h3ed; memory[2401] = 10'h3ed; memory[2402] = 10'h3ed; memory[2403] = 10'h3ed; memory[2404] = 10'h3ed; memory[2405] = 10'h3ed; memory[2406] = 10'h3ed; memory[2407] = 10'h3ed; memory[2408] = 10'h3ed; memory[2409] = 10'h3ec;
    memory[2410] = 10'h3ec; memory[2411] = 10'h3ec; memory[2412] = 10'h3ec; memory[2413] = 10'h3ec; memory[2414] = 10'h3ec; memory[2415] = 10'h3ec; memory[2416] = 10'h3ec; memory[2417] = 10'h3ec; memory[2418] = 10'h3ec; memory[2419] = 10'h3eb;
    memory[2420] = 10'h3eb; memory[2421] = 10'h3eb; memory[2422] = 10'h3eb; memory[2423] = 10'h3eb; memory[2424] = 10'h3eb; memory[2425] = 10'h3eb; memory[2426] = 10'h3eb; memory[2427] = 10'h3eb; memory[2428] = 10'h3ea; memory[2429] = 10'h3ea;
    memory[2430] = 10'h3ea; memory[2431] = 10'h3ea; memory[2432] = 10'h3ea; memory[2433] = 10'h3ea; memory[2434] = 10'h3ea; memory[2435] = 10'h3ea; memory[2436] = 10'h3e9; memory[2437] = 10'h3e9; memory[2438] = 10'h3e9; memory[2439] = 10'h3e9;
    memory[2440] = 10'h3e9; memory[2441] = 10'h3e9; memory[2442] = 10'h3e9; memory[2443] = 10'h3e9; memory[2444] = 10'h3e9; memory[2445] = 10'h3e8; memory[2446] = 10'h3e8; memory[2447] = 10'h3e8; memory[2448] = 10'h3e8; memory[2449] = 10'h3e8;
    memory[2450] = 10'h3e8; memory[2451] = 10'h3e8; memory[2452] = 10'h3e8; memory[2453] = 10'h3e7; memory[2454] = 10'h3e7; memory[2455] = 10'h3e7; memory[2456] = 10'h3e7; memory[2457] = 10'h3e7; memory[2458] = 10'h3e7; memory[2459] = 10'h3e7;
    memory[2460] = 10'h3e7; memory[2461] = 10'h3e7; memory[2462] = 10'h3e6; memory[2463] = 10'h3e6; memory[2464] = 10'h3e6; memory[2465] = 10'h3e6; memory[2466] = 10'h3e6; memory[2467] = 10'h3e6; memory[2468] = 10'h3e6; memory[2469] = 10'h3e6;
    memory[2470] = 10'h3e5; memory[2471] = 10'h3e5; memory[2472] = 10'h3e5; memory[2473] = 10'h3e5; memory[2474] = 10'h3e5; memory[2475] = 10'h3e5; memory[2476] = 10'h3e5; memory[2477] = 10'h3e5; memory[2478] = 10'h3e4; memory[2479] = 10'h3e4;
    memory[2480] = 10'h3e4; memory[2481] = 10'h3e4; memory[2482] = 10'h3e4; memory[2483] = 10'h3e4; memory[2484] = 10'h3e4; memory[2485] = 10'h3e4; memory[2486] = 10'h3e3; memory[2487] = 10'h3e3; memory[2488] = 10'h3e3; memory[2489] = 10'h3e3;
    memory[2490] = 10'h3e3; memory[2491] = 10'h3e3; memory[2492] = 10'h3e3; memory[2493] = 10'h3e2; memory[2494] = 10'h3e2; memory[2495] = 10'h3e2; memory[2496] = 10'h3e2; memory[2497] = 10'h3e2; memory[2498] = 10'h3e2; memory[2499] = 10'h3e2;
    memory[2500] = 10'h3e2; memory[2501] = 10'h3e1; memory[2502] = 10'h3e1; memory[2503] = 10'h3e1; memory[2504] = 10'h3e1; memory[2505] = 10'h3e1; memory[2506] = 10'h3e1; memory[2507] = 10'h3e1; memory[2508] = 10'h3e0; memory[2509] = 10'h3e0;
    memory[2510] = 10'h3e0; memory[2511] = 10'h3e0; memory[2512] = 10'h3e0; memory[2513] = 10'h3e0; memory[2514] = 10'h3e0; memory[2515] = 10'h3e0; memory[2516] = 10'h3df; memory[2517] = 10'h3df; memory[2518] = 10'h3df; memory[2519] = 10'h3df;
    memory[2520] = 10'h3df; memory[2521] = 10'h3df; memory[2522] = 10'h3df; memory[2523] = 10'h3de; memory[2524] = 10'h3de; memory[2525] = 10'h3de; memory[2526] = 10'h3de; memory[2527] = 10'h3de; memory[2528] = 10'h3de; memory[2529] = 10'h3de;
    memory[2530] = 10'h3dd; memory[2531] = 10'h3dd; memory[2532] = 10'h3dd; memory[2533] = 10'h3dd; memory[2534] = 10'h3dd; memory[2535] = 10'h3dd; memory[2536] = 10'h3dd; memory[2537] = 10'h3dc; memory[2538] = 10'h3dc; memory[2539] = 10'h3dc;
    memory[2540] = 10'h3dc; memory[2541] = 10'h3dc; memory[2542] = 10'h3dc; memory[2543] = 10'h3dc; memory[2544] = 10'h3db; memory[2545] = 10'h3db; memory[2546] = 10'h3db; memory[2547] = 10'h3db; memory[2548] = 10'h3db; memory[2549] = 10'h3db;
    memory[2550] = 10'h3db; memory[2551] = 10'h3da; memory[2552] = 10'h3da; memory[2553] = 10'h3da; memory[2554] = 10'h3da; memory[2555] = 10'h3da; memory[2556] = 10'h3da; memory[2557] = 10'h3d9; memory[2558] = 10'h3d9; memory[2559] = 10'h3d9;
    memory[2560] = 10'h3d9; memory[2561] = 10'h3d9; memory[2562] = 10'h3d9; memory[2563] = 10'h3d9; memory[2564] = 10'h3d8; memory[2565] = 10'h3d8; memory[2566] = 10'h3d8; memory[2567] = 10'h3d8; memory[2568] = 10'h3d8; memory[2569] = 10'h3d8;
    memory[2570] = 10'h3d8; memory[2571] = 10'h3d7; memory[2572] = 10'h3d7; memory[2573] = 10'h3d7; memory[2574] = 10'h3d7; memory[2575] = 10'h3d7; memory[2576] = 10'h3d7; memory[2577] = 10'h3d6; memory[2578] = 10'h3d6; memory[2579] = 10'h3d6;
    memory[2580] = 10'h3d6; memory[2581] = 10'h3d6; memory[2582] = 10'h3d6; memory[2583] = 10'h3d5; memory[2584] = 10'h3d5; memory[2585] = 10'h3d5; memory[2586] = 10'h3d5; memory[2587] = 10'h3d5; memory[2588] = 10'h3d5; memory[2589] = 10'h3d5;
    memory[2590] = 10'h3d4; memory[2591] = 10'h3d4; memory[2592] = 10'h3d4; memory[2593] = 10'h3d4; memory[2594] = 10'h3d4; memory[2595] = 10'h3d4; memory[2596] = 10'h3d3; memory[2597] = 10'h3d3; memory[2598] = 10'h3d3; memory[2599] = 10'h3d3;
    memory[2600] = 10'h3d3; memory[2601] = 10'h3d3; memory[2602] = 10'h3d2; memory[2603] = 10'h3d2; memory[2604] = 10'h3d2; memory[2605] = 10'h3d2; memory[2606] = 10'h3d2; memory[2607] = 10'h3d2; memory[2608] = 10'h3d1; memory[2609] = 10'h3d1;
    memory[2610] = 10'h3d1; memory[2611] = 10'h3d1; memory[2612] = 10'h3d1; memory[2613] = 10'h3d1; memory[2614] = 10'h3d1; memory[2615] = 10'h3d0; memory[2616] = 10'h3d0; memory[2617] = 10'h3d0; memory[2618] = 10'h3d0; memory[2619] = 10'h3d0;
    memory[2620] = 10'h3d0; memory[2621] = 10'h3cf; memory[2622] = 10'h3cf; memory[2623] = 10'h3cf; memory[2624] = 10'h3cf; memory[2625] = 10'h3cf; memory[2626] = 10'h3cf; memory[2627] = 10'h3ce; memory[2628] = 10'h3ce; memory[2629] = 10'h3ce;
    memory[2630] = 10'h3ce; memory[2631] = 10'h3ce; memory[2632] = 10'h3cd; memory[2633] = 10'h3cd; memory[2634] = 10'h3cd; memory[2635] = 10'h3cd; memory[2636] = 10'h3cd; memory[2637] = 10'h3cd; memory[2638] = 10'h3cc; memory[2639] = 10'h3cc;
    memory[2640] = 10'h3cc; memory[2641] = 10'h3cc; memory[2642] = 10'h3cc; memory[2643] = 10'h3cc; memory[2644] = 10'h3cb; memory[2645] = 10'h3cb; memory[2646] = 10'h3cb; memory[2647] = 10'h3cb; memory[2648] = 10'h3cb; memory[2649] = 10'h3cb;
    memory[2650] = 10'h3ca; memory[2651] = 10'h3ca; memory[2652] = 10'h3ca; memory[2653] = 10'h3ca; memory[2654] = 10'h3ca; memory[2655] = 10'h3ca; memory[2656] = 10'h3c9; memory[2657] = 10'h3c9; memory[2658] = 10'h3c9; memory[2659] = 10'h3c9;
    memory[2660] = 10'h3c9; memory[2661] = 10'h3c8; memory[2662] = 10'h3c8; memory[2663] = 10'h3c8; memory[2664] = 10'h3c8; memory[2665] = 10'h3c8; memory[2666] = 10'h3c8; memory[2667] = 10'h3c7; memory[2668] = 10'h3c7; memory[2669] = 10'h3c7;
    memory[2670] = 10'h3c7; memory[2671] = 10'h3c7; memory[2672] = 10'h3c6; memory[2673] = 10'h3c6; memory[2674] = 10'h3c6; memory[2675] = 10'h3c6; memory[2676] = 10'h3c6; memory[2677] = 10'h3c6; memory[2678] = 10'h3c5; memory[2679] = 10'h3c5;
    memory[2680] = 10'h3c5; memory[2681] = 10'h3c5; memory[2682] = 10'h3c5; memory[2683] = 10'h3c4; memory[2684] = 10'h3c4; memory[2685] = 10'h3c4; memory[2686] = 10'h3c4; memory[2687] = 10'h3c4; memory[2688] = 10'h3c4; memory[2689] = 10'h3c3;
    memory[2690] = 10'h3c3; memory[2691] = 10'h3c3; memory[2692] = 10'h3c3; memory[2693] = 10'h3c3; memory[2694] = 10'h3c2; memory[2695] = 10'h3c2; memory[2696] = 10'h3c2; memory[2697] = 10'h3c2; memory[2698] = 10'h3c2; memory[2699] = 10'h3c1;
    memory[2700] = 10'h3c1; memory[2701] = 10'h3c1; memory[2702] = 10'h3c1; memory[2703] = 10'h3c1; memory[2704] = 10'h3c1; memory[2705] = 10'h3c0; memory[2706] = 10'h3c0; memory[2707] = 10'h3c0; memory[2708] = 10'h3c0; memory[2709] = 10'h3c0;
    memory[2710] = 10'h3bf; memory[2711] = 10'h3bf; memory[2712] = 10'h3bf; memory[2713] = 10'h3bf; memory[2714] = 10'h3bf; memory[2715] = 10'h3be; memory[2716] = 10'h3be; memory[2717] = 10'h3be; memory[2718] = 10'h3be; memory[2719] = 10'h3be;
    memory[2720] = 10'h3bd; memory[2721] = 10'h3bd; memory[2722] = 10'h3bd; memory[2723] = 10'h3bd; memory[2724] = 10'h3bd; memory[2725] = 10'h3bd; memory[2726] = 10'h3bc; memory[2727] = 10'h3bc; memory[2728] = 10'h3bc; memory[2729] = 10'h3bc;
    memory[2730] = 10'h3bc; memory[2731] = 10'h3bb; memory[2732] = 10'h3bb; memory[2733] = 10'h3bb; memory[2734] = 10'h3bb; memory[2735] = 10'h3bb; memory[2736] = 10'h3ba; memory[2737] = 10'h3ba; memory[2738] = 10'h3ba; memory[2739] = 10'h3ba;
    memory[2740] = 10'h3ba; memory[2741] = 10'h3b9; memory[2742] = 10'h3b9; memory[2743] = 10'h3b9; memory[2744] = 10'h3b9; memory[2745] = 10'h3b9; memory[2746] = 10'h3b8; memory[2747] = 10'h3b8; memory[2748] = 10'h3b8; memory[2749] = 10'h3b8;
    memory[2750] = 10'h3b8; memory[2751] = 10'h3b7; memory[2752] = 10'h3b7; memory[2753] = 10'h3b7; memory[2754] = 10'h3b7; memory[2755] = 10'h3b7; memory[2756] = 10'h3b6; memory[2757] = 10'h3b6; memory[2758] = 10'h3b6; memory[2759] = 10'h3b6;
    memory[2760] = 10'h3b6; memory[2761] = 10'h3b5; memory[2762] = 10'h3b5; memory[2763] = 10'h3b5; memory[2764] = 10'h3b5; memory[2765] = 10'h3b5; memory[2766] = 10'h3b4; memory[2767] = 10'h3b4; memory[2768] = 10'h3b4; memory[2769] = 10'h3b4;
    memory[2770] = 10'h3b3; memory[2771] = 10'h3b3; memory[2772] = 10'h3b3; memory[2773] = 10'h3b3; memory[2774] = 10'h3b3; memory[2775] = 10'h3b2; memory[2776] = 10'h3b2; memory[2777] = 10'h3b2; memory[2778] = 10'h3b2; memory[2779] = 10'h3b2;
    memory[2780] = 10'h3b1; memory[2781] = 10'h3b1; memory[2782] = 10'h3b1; memory[2783] = 10'h3b1; memory[2784] = 10'h3b1; memory[2785] = 10'h3b0; memory[2786] = 10'h3b0; memory[2787] = 10'h3b0; memory[2788] = 10'h3b0; memory[2789] = 10'h3b0;
    memory[2790] = 10'h3af; memory[2791] = 10'h3af; memory[2792] = 10'h3af; memory[2793] = 10'h3af; memory[2794] = 10'h3ae; memory[2795] = 10'h3ae; memory[2796] = 10'h3ae; memory[2797] = 10'h3ae; memory[2798] = 10'h3ae; memory[2799] = 10'h3ad;
    memory[2800] = 10'h3ad; memory[2801] = 10'h3ad; memory[2802] = 10'h3ad; memory[2803] = 10'h3ad; memory[2804] = 10'h3ac; memory[2805] = 10'h3ac; memory[2806] = 10'h3ac; memory[2807] = 10'h3ac; memory[2808] = 10'h3ab; memory[2809] = 10'h3ab;
    memory[2810] = 10'h3ab; memory[2811] = 10'h3ab; memory[2812] = 10'h3ab; memory[2813] = 10'h3aa; memory[2814] = 10'h3aa; memory[2815] = 10'h3aa; memory[2816] = 10'h3aa; memory[2817] = 10'h3a9; memory[2818] = 10'h3a9; memory[2819] = 10'h3a9;
    memory[2820] = 10'h3a9; memory[2821] = 10'h3a9; memory[2822] = 10'h3a8; memory[2823] = 10'h3a8; memory[2824] = 10'h3a8; memory[2825] = 10'h3a8; memory[2826] = 10'h3a8; memory[2827] = 10'h3a7; memory[2828] = 10'h3a7; memory[2829] = 10'h3a7;
    memory[2830] = 10'h3a7; memory[2831] = 10'h3a6; memory[2832] = 10'h3a6; memory[2833] = 10'h3a6; memory[2834] = 10'h3a6; memory[2835] = 10'h3a6; memory[2836] = 10'h3a5; memory[2837] = 10'h3a5; memory[2838] = 10'h3a5; memory[2839] = 10'h3a5;
    memory[2840] = 10'h3a4; memory[2841] = 10'h3a4; memory[2842] = 10'h3a4; memory[2843] = 10'h3a4; memory[2844] = 10'h3a4; memory[2845] = 10'h3a3; memory[2846] = 10'h3a3; memory[2847] = 10'h3a3; memory[2848] = 10'h3a3; memory[2849] = 10'h3a2;
    memory[2850] = 10'h3a2; memory[2851] = 10'h3a2; memory[2852] = 10'h3a2; memory[2853] = 10'h3a1; memory[2854] = 10'h3a1; memory[2855] = 10'h3a1; memory[2856] = 10'h3a1; memory[2857] = 10'h3a1; memory[2858] = 10'h3a0; memory[2859] = 10'h3a0;
    memory[2860] = 10'h3a0; memory[2861] = 10'h3a0; memory[2862] = 10'h39f; memory[2863] = 10'h39f; memory[2864] = 10'h39f; memory[2865] = 10'h39f; memory[2866] = 10'h39e; memory[2867] = 10'h39e; memory[2868] = 10'h39e; memory[2869] = 10'h39e;
    memory[2870] = 10'h39e; memory[2871] = 10'h39d; memory[2872] = 10'h39d; memory[2873] = 10'h39d; memory[2874] = 10'h39d; memory[2875] = 10'h39c; memory[2876] = 10'h39c; memory[2877] = 10'h39c; memory[2878] = 10'h39c; memory[2879] = 10'h39b;
    memory[2880] = 10'h39b; memory[2881] = 10'h39b; memory[2882] = 10'h39b; memory[2883] = 10'h39b; memory[2884] = 10'h39a; memory[2885] = 10'h39a; memory[2886] = 10'h39a; memory[2887] = 10'h39a; memory[2888] = 10'h399; memory[2889] = 10'h399;
    memory[2890] = 10'h399; memory[2891] = 10'h399; memory[2892] = 10'h398; memory[2893] = 10'h398; memory[2894] = 10'h398; memory[2895] = 10'h398; memory[2896] = 10'h397; memory[2897] = 10'h397; memory[2898] = 10'h397; memory[2899] = 10'h397;
    memory[2900] = 10'h397; memory[2901] = 10'h396; memory[2902] = 10'h396; memory[2903] = 10'h396; memory[2904] = 10'h396; memory[2905] = 10'h395; memory[2906] = 10'h395; memory[2907] = 10'h395; memory[2908] = 10'h395; memory[2909] = 10'h394;
    memory[2910] = 10'h394; memory[2911] = 10'h394; memory[2912] = 10'h394; memory[2913] = 10'h393; memory[2914] = 10'h393; memory[2915] = 10'h393; memory[2916] = 10'h393; memory[2917] = 10'h392; memory[2918] = 10'h392; memory[2919] = 10'h392;
    memory[2920] = 10'h392; memory[2921] = 10'h391; memory[2922] = 10'h391; memory[2923] = 10'h391; memory[2924] = 10'h391; memory[2925] = 10'h390; memory[2926] = 10'h390; memory[2927] = 10'h390; memory[2928] = 10'h390; memory[2929] = 10'h38f;
    memory[2930] = 10'h38f; memory[2931] = 10'h38f; memory[2932] = 10'h38f; memory[2933] = 10'h38f; memory[2934] = 10'h38e; memory[2935] = 10'h38e; memory[2936] = 10'h38e; memory[2937] = 10'h38e; memory[2938] = 10'h38d; memory[2939] = 10'h38d;
    memory[2940] = 10'h38d; memory[2941] = 10'h38d; memory[2942] = 10'h38c; memory[2943] = 10'h38c; memory[2944] = 10'h38c; memory[2945] = 10'h38c; memory[2946] = 10'h38b; memory[2947] = 10'h38b; memory[2948] = 10'h38b; memory[2949] = 10'h38b;
    memory[2950] = 10'h38a; memory[2951] = 10'h38a; memory[2952] = 10'h38a; memory[2953] = 10'h38a; memory[2954] = 10'h389; memory[2955] = 10'h389; memory[2956] = 10'h389; memory[2957] = 10'h389; memory[2958] = 10'h388; memory[2959] = 10'h388;
    memory[2960] = 10'h388; memory[2961] = 10'h388; memory[2962] = 10'h387; memory[2963] = 10'h387; memory[2964] = 10'h387; memory[2965] = 10'h386; memory[2966] = 10'h386; memory[2967] = 10'h386; memory[2968] = 10'h386; memory[2969] = 10'h385;
    memory[2970] = 10'h385; memory[2971] = 10'h385; memory[2972] = 10'h385; memory[2973] = 10'h384; memory[2974] = 10'h384; memory[2975] = 10'h384; memory[2976] = 10'h384; memory[2977] = 10'h383; memory[2978] = 10'h383; memory[2979] = 10'h383;
    memory[2980] = 10'h383; memory[2981] = 10'h382; memory[2982] = 10'h382; memory[2983] = 10'h382; memory[2984] = 10'h382; memory[2985] = 10'h381; memory[2986] = 10'h381; memory[2987] = 10'h381; memory[2988] = 10'h381; memory[2989] = 10'h380;
    memory[2990] = 10'h380; memory[2991] = 10'h380; memory[2992] = 10'h380; memory[2993] = 10'h37f; memory[2994] = 10'h37f; memory[2995] = 10'h37f; memory[2996] = 10'h37f; memory[2997] = 10'h37e; memory[2998] = 10'h37e; memory[2999] = 10'h37e;
    memory[3000] = 10'h37d; memory[3001] = 10'h37d; memory[3002] = 10'h37d; memory[3003] = 10'h37d; memory[3004] = 10'h37c; memory[3005] = 10'h37c; memory[3006] = 10'h37c; memory[3007] = 10'h37c; memory[3008] = 10'h37b; memory[3009] = 10'h37b;
    memory[3010] = 10'h37b; memory[3011] = 10'h37b; memory[3012] = 10'h37a; memory[3013] = 10'h37a; memory[3014] = 10'h37a; memory[3015] = 10'h37a; memory[3016] = 10'h379; memory[3017] = 10'h379; memory[3018] = 10'h379; memory[3019] = 10'h378;
    memory[3020] = 10'h378; memory[3021] = 10'h378; memory[3022] = 10'h378; memory[3023] = 10'h377; memory[3024] = 10'h377; memory[3025] = 10'h377; memory[3026] = 10'h377; memory[3027] = 10'h376; memory[3028] = 10'h376; memory[3029] = 10'h376;
    memory[3030] = 10'h376; memory[3031] = 10'h375; memory[3032] = 10'h375; memory[3033] = 10'h375; memory[3034] = 10'h374; memory[3035] = 10'h374; memory[3036] = 10'h374; memory[3037] = 10'h374; memory[3038] = 10'h373; memory[3039] = 10'h373;
    memory[3040] = 10'h373; memory[3041] = 10'h373; memory[3042] = 10'h372; memory[3043] = 10'h372; memory[3044] = 10'h372; memory[3045] = 10'h371; memory[3046] = 10'h371; memory[3047] = 10'h371; memory[3048] = 10'h371; memory[3049] = 10'h370;
    memory[3050] = 10'h370; memory[3051] = 10'h370; memory[3052] = 10'h370; memory[3053] = 10'h36f; memory[3054] = 10'h36f; memory[3055] = 10'h36f; memory[3056] = 10'h36e; memory[3057] = 10'h36e; memory[3058] = 10'h36e; memory[3059] = 10'h36e;
    memory[3060] = 10'h36d; memory[3061] = 10'h36d; memory[3062] = 10'h36d; memory[3063] = 10'h36d; memory[3064] = 10'h36c; memory[3065] = 10'h36c; memory[3066] = 10'h36c; memory[3067] = 10'h36b; memory[3068] = 10'h36b; memory[3069] = 10'h36b;
    memory[3070] = 10'h36b; memory[3071] = 10'h36a; memory[3072] = 10'h36a; memory[3073] = 10'h36a; memory[3074] = 10'h369; memory[3075] = 10'h369; memory[3076] = 10'h369; memory[3077] = 10'h369; memory[3078] = 10'h368; memory[3079] = 10'h368;
    memory[3080] = 10'h368; memory[3081] = 10'h368; memory[3082] = 10'h367; memory[3083] = 10'h367; memory[3084] = 10'h367; memory[3085] = 10'h366; memory[3086] = 10'h366; memory[3087] = 10'h366; memory[3088] = 10'h366; memory[3089] = 10'h365;
    memory[3090] = 10'h365; memory[3091] = 10'h365; memory[3092] = 10'h364; memory[3093] = 10'h364; memory[3094] = 10'h364; memory[3095] = 10'h364; memory[3096] = 10'h363; memory[3097] = 10'h363; memory[3098] = 10'h363; memory[3099] = 10'h362;
    memory[3100] = 10'h362; memory[3101] = 10'h362; memory[3102] = 10'h362; memory[3103] = 10'h361; memory[3104] = 10'h361; memory[3105] = 10'h361; memory[3106] = 10'h360; memory[3107] = 10'h360; memory[3108] = 10'h360; memory[3109] = 10'h360;
    memory[3110] = 10'h35f; memory[3111] = 10'h35f; memory[3112] = 10'h35f; memory[3113] = 10'h35e; memory[3114] = 10'h35e; memory[3115] = 10'h35e; memory[3116] = 10'h35e; memory[3117] = 10'h35d; memory[3118] = 10'h35d; memory[3119] = 10'h35d;
    memory[3120] = 10'h35c; memory[3121] = 10'h35c; memory[3122] = 10'h35c; memory[3123] = 10'h35c; memory[3124] = 10'h35b; memory[3125] = 10'h35b; memory[3126] = 10'h35b; memory[3127] = 10'h35a; memory[3128] = 10'h35a; memory[3129] = 10'h35a;
    memory[3130] = 10'h35a; memory[3131] = 10'h359; memory[3132] = 10'h359; memory[3133] = 10'h359; memory[3134] = 10'h358; memory[3135] = 10'h358; memory[3136] = 10'h358; memory[3137] = 10'h358; memory[3138] = 10'h357; memory[3139] = 10'h357;
    memory[3140] = 10'h357; memory[3141] = 10'h356; memory[3142] = 10'h356; memory[3143] = 10'h356; memory[3144] = 10'h356; memory[3145] = 10'h355; memory[3146] = 10'h355; memory[3147] = 10'h355; memory[3148] = 10'h354; memory[3149] = 10'h354;
    memory[3150] = 10'h354; memory[3151] = 10'h353; memory[3152] = 10'h353; memory[3153] = 10'h353; memory[3154] = 10'h353; memory[3155] = 10'h352; memory[3156] = 10'h352; memory[3157] = 10'h352; memory[3158] = 10'h351; memory[3159] = 10'h351;
    memory[3160] = 10'h351; memory[3161] = 10'h351; memory[3162] = 10'h350; memory[3163] = 10'h350; memory[3164] = 10'h350; memory[3165] = 10'h34f; memory[3166] = 10'h34f; memory[3167] = 10'h34f; memory[3168] = 10'h34e; memory[3169] = 10'h34e;
    memory[3170] = 10'h34e; memory[3171] = 10'h34e; memory[3172] = 10'h34d; memory[3173] = 10'h34d; memory[3174] = 10'h34d; memory[3175] = 10'h34c; memory[3176] = 10'h34c; memory[3177] = 10'h34c; memory[3178] = 10'h34b; memory[3179] = 10'h34b;
    memory[3180] = 10'h34b; memory[3181] = 10'h34b; memory[3182] = 10'h34a; memory[3183] = 10'h34a; memory[3184] = 10'h34a; memory[3185] = 10'h349; memory[3186] = 10'h349; memory[3187] = 10'h349; memory[3188] = 10'h348; memory[3189] = 10'h348;
    memory[3190] = 10'h348; memory[3191] = 10'h348; memory[3192] = 10'h347; memory[3193] = 10'h347; memory[3194] = 10'h347; memory[3195] = 10'h346; memory[3196] = 10'h346; memory[3197] = 10'h346; memory[3198] = 10'h345; memory[3199] = 10'h345;
    memory[3200] = 10'h345; memory[3201] = 10'h345; memory[3202] = 10'h344; memory[3203] = 10'h344; memory[3204] = 10'h344; memory[3205] = 10'h343; memory[3206] = 10'h343; memory[3207] = 10'h343; memory[3208] = 10'h342; memory[3209] = 10'h342;
    memory[3210] = 10'h342; memory[3211] = 10'h341; memory[3212] = 10'h341; memory[3213] = 10'h341; memory[3214] = 10'h341; memory[3215] = 10'h340; memory[3216] = 10'h340; memory[3217] = 10'h340; memory[3218] = 10'h33f; memory[3219] = 10'h33f;
    memory[3220] = 10'h33f; memory[3221] = 10'h33e; memory[3222] = 10'h33e; memory[3223] = 10'h33e; memory[3224] = 10'h33d; memory[3225] = 10'h33d; memory[3226] = 10'h33d; memory[3227] = 10'h33d; memory[3228] = 10'h33c; memory[3229] = 10'h33c;
    memory[3230] = 10'h33c; memory[3231] = 10'h33b; memory[3232] = 10'h33b; memory[3233] = 10'h33b; memory[3234] = 10'h33a; memory[3235] = 10'h33a; memory[3236] = 10'h33a; memory[3237] = 10'h339; memory[3238] = 10'h339; memory[3239] = 10'h339;
    memory[3240] = 10'h339; memory[3241] = 10'h338; memory[3242] = 10'h338; memory[3243] = 10'h338; memory[3244] = 10'h337; memory[3245] = 10'h337; memory[3246] = 10'h337; memory[3247] = 10'h336; memory[3248] = 10'h336; memory[3249] = 10'h336;
    memory[3250] = 10'h335; memory[3251] = 10'h335; memory[3252] = 10'h335; memory[3253] = 10'h334; memory[3254] = 10'h334; memory[3255] = 10'h334; memory[3256] = 10'h334; memory[3257] = 10'h333; memory[3258] = 10'h333; memory[3259] = 10'h333;
    memory[3260] = 10'h332; memory[3261] = 10'h332; memory[3262] = 10'h332; memory[3263] = 10'h331; memory[3264] = 10'h331; memory[3265] = 10'h331; memory[3266] = 10'h330; memory[3267] = 10'h330; memory[3268] = 10'h330; memory[3269] = 10'h32f;
    memory[3270] = 10'h32f; memory[3271] = 10'h32f; memory[3272] = 10'h32e; memory[3273] = 10'h32e; memory[3274] = 10'h32e; memory[3275] = 10'h32e; memory[3276] = 10'h32d; memory[3277] = 10'h32d; memory[3278] = 10'h32d; memory[3279] = 10'h32c;
    memory[3280] = 10'h32c; memory[3281] = 10'h32c; memory[3282] = 10'h32b; memory[3283] = 10'h32b; memory[3284] = 10'h32b; memory[3285] = 10'h32a; memory[3286] = 10'h32a; memory[3287] = 10'h32a; memory[3288] = 10'h329; memory[3289] = 10'h329;
    memory[3290] = 10'h329; memory[3291] = 10'h328; memory[3292] = 10'h328; memory[3293] = 10'h328; memory[3294] = 10'h327; memory[3295] = 10'h327; memory[3296] = 10'h327; memory[3297] = 10'h326; memory[3298] = 10'h326; memory[3299] = 10'h326;
    memory[3300] = 10'h326; memory[3301] = 10'h325; memory[3302] = 10'h325; memory[3303] = 10'h325; memory[3304] = 10'h324; memory[3305] = 10'h324; memory[3306] = 10'h324; memory[3307] = 10'h323; memory[3308] = 10'h323; memory[3309] = 10'h323;
    memory[3310] = 10'h322; memory[3311] = 10'h322; memory[3312] = 10'h322; memory[3313] = 10'h321; memory[3314] = 10'h321; memory[3315] = 10'h321; memory[3316] = 10'h320; memory[3317] = 10'h320; memory[3318] = 10'h320; memory[3319] = 10'h31f;
    memory[3320] = 10'h31f; memory[3321] = 10'h31f; memory[3322] = 10'h31e; memory[3323] = 10'h31e; memory[3324] = 10'h31e; memory[3325] = 10'h31d; memory[3326] = 10'h31d; memory[3327] = 10'h31d; memory[3328] = 10'h31c; memory[3329] = 10'h31c;
    memory[3330] = 10'h31c; memory[3331] = 10'h31b; memory[3332] = 10'h31b; memory[3333] = 10'h31b; memory[3334] = 10'h31a; memory[3335] = 10'h31a; memory[3336] = 10'h31a; memory[3337] = 10'h31a; memory[3338] = 10'h319; memory[3339] = 10'h319;
    memory[3340] = 10'h319; memory[3341] = 10'h318; memory[3342] = 10'h318; memory[3343] = 10'h318; memory[3344] = 10'h317; memory[3345] = 10'h317; memory[3346] = 10'h317; memory[3347] = 10'h316; memory[3348] = 10'h316; memory[3349] = 10'h316;
    memory[3350] = 10'h315; memory[3351] = 10'h315; memory[3352] = 10'h315; memory[3353] = 10'h314; memory[3354] = 10'h314; memory[3355] = 10'h314; memory[3356] = 10'h313; memory[3357] = 10'h313; memory[3358] = 10'h313; memory[3359] = 10'h312;
    memory[3360] = 10'h312; memory[3361] = 10'h312; memory[3362] = 10'h311; memory[3363] = 10'h311; memory[3364] = 10'h311; memory[3365] = 10'h310; memory[3366] = 10'h310; memory[3367] = 10'h310; memory[3368] = 10'h30f; memory[3369] = 10'h30f;
    memory[3370] = 10'h30f; memory[3371] = 10'h30e; memory[3372] = 10'h30e; memory[3373] = 10'h30e; memory[3374] = 10'h30d; memory[3375] = 10'h30d; memory[3376] = 10'h30d; memory[3377] = 10'h30c; memory[3378] = 10'h30c; memory[3379] = 10'h30c;
    memory[3380] = 10'h30b; memory[3381] = 10'h30b; memory[3382] = 10'h30b; memory[3383] = 10'h30a; memory[3384] = 10'h30a; memory[3385] = 10'h30a; memory[3386] = 10'h309; memory[3387] = 10'h309; memory[3388] = 10'h309; memory[3389] = 10'h308;
    memory[3390] = 10'h308; memory[3391] = 10'h308; memory[3392] = 10'h307; memory[3393] = 10'h307; memory[3394] = 10'h307; memory[3395] = 10'h306; memory[3396] = 10'h306; memory[3397] = 10'h306; memory[3398] = 10'h305; memory[3399] = 10'h305;
    memory[3400] = 10'h305; memory[3401] = 10'h304; memory[3402] = 10'h304; memory[3403] = 10'h304; memory[3404] = 10'h303; memory[3405] = 10'h303; memory[3406] = 10'h302; memory[3407] = 10'h302; memory[3408] = 10'h302; memory[3409] = 10'h301;
    memory[3410] = 10'h301; memory[3411] = 10'h301; memory[3412] = 10'h300; memory[3413] = 10'h300; memory[3414] = 10'h300; memory[3415] = 10'h2ff; memory[3416] = 10'h2ff; memory[3417] = 10'h2ff; memory[3418] = 10'h2fe; memory[3419] = 10'h2fe;
    memory[3420] = 10'h2fe; memory[3421] = 10'h2fd; memory[3422] = 10'h2fd; memory[3423] = 10'h2fd; memory[3424] = 10'h2fc; memory[3425] = 10'h2fc; memory[3426] = 10'h2fc; memory[3427] = 10'h2fb; memory[3428] = 10'h2fb; memory[3429] = 10'h2fb;
    memory[3430] = 10'h2fa; memory[3431] = 10'h2fa; memory[3432] = 10'h2fa; memory[3433] = 10'h2f9; memory[3434] = 10'h2f9; memory[3435] = 10'h2f9; memory[3436] = 10'h2f8; memory[3437] = 10'h2f8; memory[3438] = 10'h2f8; memory[3439] = 10'h2f7;
    memory[3440] = 10'h2f7; memory[3441] = 10'h2f7; memory[3442] = 10'h2f6; memory[3443] = 10'h2f6; memory[3444] = 10'h2f6; memory[3445] = 10'h2f5; memory[3446] = 10'h2f5; memory[3447] = 10'h2f4; memory[3448] = 10'h2f4; memory[3449] = 10'h2f4;
    memory[3450] = 10'h2f3; memory[3451] = 10'h2f3; memory[3452] = 10'h2f3; memory[3453] = 10'h2f2; memory[3454] = 10'h2f2; memory[3455] = 10'h2f2; memory[3456] = 10'h2f1; memory[3457] = 10'h2f1; memory[3458] = 10'h2f1; memory[3459] = 10'h2f0;
    memory[3460] = 10'h2f0; memory[3461] = 10'h2f0; memory[3462] = 10'h2ef; memory[3463] = 10'h2ef; memory[3464] = 10'h2ef; memory[3465] = 10'h2ee; memory[3466] = 10'h2ee; memory[3467] = 10'h2ee; memory[3468] = 10'h2ed; memory[3469] = 10'h2ed;
    memory[3470] = 10'h2ec; memory[3471] = 10'h2ec; memory[3472] = 10'h2ec; memory[3473] = 10'h2eb; memory[3474] = 10'h2eb; memory[3475] = 10'h2eb; memory[3476] = 10'h2ea; memory[3477] = 10'h2ea; memory[3478] = 10'h2ea; memory[3479] = 10'h2e9;
    memory[3480] = 10'h2e9; memory[3481] = 10'h2e9; memory[3482] = 10'h2e8; memory[3483] = 10'h2e8; memory[3484] = 10'h2e8; memory[3485] = 10'h2e7; memory[3486] = 10'h2e7; memory[3487] = 10'h2e7; memory[3488] = 10'h2e6; memory[3489] = 10'h2e6;
    memory[3490] = 10'h2e5; memory[3491] = 10'h2e5; memory[3492] = 10'h2e5; memory[3493] = 10'h2e4; memory[3494] = 10'h2e4; memory[3495] = 10'h2e4; memory[3496] = 10'h2e3; memory[3497] = 10'h2e3; memory[3498] = 10'h2e3; memory[3499] = 10'h2e2;
    memory[3500] = 10'h2e2; memory[3501] = 10'h2e2; memory[3502] = 10'h2e1; memory[3503] = 10'h2e1; memory[3504] = 10'h2e1; memory[3505] = 10'h2e0; memory[3506] = 10'h2e0; memory[3507] = 10'h2e0; memory[3508] = 10'h2df; memory[3509] = 10'h2df;
    memory[3510] = 10'h2de; memory[3511] = 10'h2de; memory[3512] = 10'h2de; memory[3513] = 10'h2dd; memory[3514] = 10'h2dd; memory[3515] = 10'h2dd; memory[3516] = 10'h2dc; memory[3517] = 10'h2dc; memory[3518] = 10'h2dc; memory[3519] = 10'h2db;
    memory[3520] = 10'h2db; memory[3521] = 10'h2db; memory[3522] = 10'h2da; memory[3523] = 10'h2da; memory[3524] = 10'h2d9; memory[3525] = 10'h2d9; memory[3526] = 10'h2d9; memory[3527] = 10'h2d8; memory[3528] = 10'h2d8; memory[3529] = 10'h2d8;
    memory[3530] = 10'h2d7; memory[3531] = 10'h2d7; memory[3532] = 10'h2d7; memory[3533] = 10'h2d6; memory[3534] = 10'h2d6; memory[3535] = 10'h2d6; memory[3536] = 10'h2d5; memory[3537] = 10'h2d5; memory[3538] = 10'h2d4; memory[3539] = 10'h2d4;
    memory[3540] = 10'h2d4; memory[3541] = 10'h2d3; memory[3542] = 10'h2d3; memory[3543] = 10'h2d3; memory[3544] = 10'h2d2; memory[3545] = 10'h2d2; memory[3546] = 10'h2d2; memory[3547] = 10'h2d1; memory[3548] = 10'h2d1; memory[3549] = 10'h2d1;
    memory[3550] = 10'h2d0; memory[3551] = 10'h2d0; memory[3552] = 10'h2cf; memory[3553] = 10'h2cf; memory[3554] = 10'h2cf; memory[3555] = 10'h2ce; memory[3556] = 10'h2ce; memory[3557] = 10'h2ce; memory[3558] = 10'h2cd; memory[3559] = 10'h2cd;
    memory[3560] = 10'h2cd; memory[3561] = 10'h2cc; memory[3562] = 10'h2cc; memory[3563] = 10'h2cc; memory[3564] = 10'h2cb; memory[3565] = 10'h2cb; memory[3566] = 10'h2ca; memory[3567] = 10'h2ca; memory[3568] = 10'h2ca; memory[3569] = 10'h2c9;
    memory[3570] = 10'h2c9; memory[3571] = 10'h2c9; memory[3572] = 10'h2c8; memory[3573] = 10'h2c8; memory[3574] = 10'h2c8; memory[3575] = 10'h2c7; memory[3576] = 10'h2c7; memory[3577] = 10'h2c6; memory[3578] = 10'h2c6; memory[3579] = 10'h2c6;
    memory[3580] = 10'h2c5; memory[3581] = 10'h2c5; memory[3582] = 10'h2c5; memory[3583] = 10'h2c4; memory[3584] = 10'h2c4; memory[3585] = 10'h2c4; memory[3586] = 10'h2c3; memory[3587] = 10'h2c3; memory[3588] = 10'h2c2; memory[3589] = 10'h2c2;
    memory[3590] = 10'h2c2; memory[3591] = 10'h2c1; memory[3592] = 10'h2c1; memory[3593] = 10'h2c1; memory[3594] = 10'h2c0; memory[3595] = 10'h2c0; memory[3596] = 10'h2c0; memory[3597] = 10'h2bf; memory[3598] = 10'h2bf; memory[3599] = 10'h2be;
    memory[3600] = 10'h2be; memory[3601] = 10'h2be; memory[3602] = 10'h2bd; memory[3603] = 10'h2bd; memory[3604] = 10'h2bd; memory[3605] = 10'h2bc; memory[3606] = 10'h2bc; memory[3607] = 10'h2bc; memory[3608] = 10'h2bb; memory[3609] = 10'h2bb;
    memory[3610] = 10'h2ba; memory[3611] = 10'h2ba; memory[3612] = 10'h2ba; memory[3613] = 10'h2b9; memory[3614] = 10'h2b9; memory[3615] = 10'h2b9; memory[3616] = 10'h2b8; memory[3617] = 10'h2b8; memory[3618] = 10'h2b8; memory[3619] = 10'h2b7;
    memory[3620] = 10'h2b7; memory[3621] = 10'h2b6; memory[3622] = 10'h2b6; memory[3623] = 10'h2b6; memory[3624] = 10'h2b5; memory[3625] = 10'h2b5; memory[3626] = 10'h2b5; memory[3627] = 10'h2b4; memory[3628] = 10'h2b4; memory[3629] = 10'h2b3;
    memory[3630] = 10'h2b3; memory[3631] = 10'h2b3; memory[3632] = 10'h2b2; memory[3633] = 10'h2b2; memory[3634] = 10'h2b2; memory[3635] = 10'h2b1; memory[3636] = 10'h2b1; memory[3637] = 10'h2b1; memory[3638] = 10'h2b0; memory[3639] = 10'h2b0;
    memory[3640] = 10'h2af; memory[3641] = 10'h2af; memory[3642] = 10'h2af; memory[3643] = 10'h2ae; memory[3644] = 10'h2ae; memory[3645] = 10'h2ae; memory[3646] = 10'h2ad; memory[3647] = 10'h2ad; memory[3648] = 10'h2ac; memory[3649] = 10'h2ac;
    memory[3650] = 10'h2ac; memory[3651] = 10'h2ab; memory[3652] = 10'h2ab; memory[3653] = 10'h2ab; memory[3654] = 10'h2aa; memory[3655] = 10'h2aa; memory[3656] = 10'h2aa; memory[3657] = 10'h2a9; memory[3658] = 10'h2a9; memory[3659] = 10'h2a8;
    memory[3660] = 10'h2a8; memory[3661] = 10'h2a8; memory[3662] = 10'h2a7; memory[3663] = 10'h2a7; memory[3664] = 10'h2a7; memory[3665] = 10'h2a6; memory[3666] = 10'h2a6; memory[3667] = 10'h2a5; memory[3668] = 10'h2a5; memory[3669] = 10'h2a5;
    memory[3670] = 10'h2a4; memory[3671] = 10'h2a4; memory[3672] = 10'h2a4; memory[3673] = 10'h2a3; memory[3674] = 10'h2a3; memory[3675] = 10'h2a2; memory[3676] = 10'h2a2; memory[3677] = 10'h2a2; memory[3678] = 10'h2a1; memory[3679] = 10'h2a1;
    memory[3680] = 10'h2a1; memory[3681] = 10'h2a0; memory[3682] = 10'h2a0; memory[3683] = 10'h29f; memory[3684] = 10'h29f; memory[3685] = 10'h29f; memory[3686] = 10'h29e; memory[3687] = 10'h29e; memory[3688] = 10'h29e; memory[3689] = 10'h29d;
    memory[3690] = 10'h29d; memory[3691] = 10'h29c; memory[3692] = 10'h29c; memory[3693] = 10'h29c; memory[3694] = 10'h29b; memory[3695] = 10'h29b; memory[3696] = 10'h29b; memory[3697] = 10'h29a; memory[3698] = 10'h29a; memory[3699] = 10'h29a;
    memory[3700] = 10'h299; memory[3701] = 10'h299; memory[3702] = 10'h298; memory[3703] = 10'h298; memory[3704] = 10'h298; memory[3705] = 10'h297; memory[3706] = 10'h297; memory[3707] = 10'h297; memory[3708] = 10'h296; memory[3709] = 10'h296;
    memory[3710] = 10'h295; memory[3711] = 10'h295; memory[3712] = 10'h295; memory[3713] = 10'h294; memory[3714] = 10'h294; memory[3715] = 10'h293; memory[3716] = 10'h293; memory[3717] = 10'h293; memory[3718] = 10'h292; memory[3719] = 10'h292;
    memory[3720] = 10'h292; memory[3721] = 10'h291; memory[3722] = 10'h291; memory[3723] = 10'h290; memory[3724] = 10'h290; memory[3725] = 10'h290; memory[3726] = 10'h28f; memory[3727] = 10'h28f; memory[3728] = 10'h28f; memory[3729] = 10'h28e;
    memory[3730] = 10'h28e; memory[3731] = 10'h28d; memory[3732] = 10'h28d; memory[3733] = 10'h28d; memory[3734] = 10'h28c; memory[3735] = 10'h28c; memory[3736] = 10'h28c; memory[3737] = 10'h28b; memory[3738] = 10'h28b; memory[3739] = 10'h28a;
    memory[3740] = 10'h28a; memory[3741] = 10'h28a; memory[3742] = 10'h289; memory[3743] = 10'h289; memory[3744] = 10'h289; memory[3745] = 10'h288; memory[3746] = 10'h288; memory[3747] = 10'h287; memory[3748] = 10'h287; memory[3749] = 10'h287;
    memory[3750] = 10'h286; memory[3751] = 10'h286; memory[3752] = 10'h286; memory[3753] = 10'h285; memory[3754] = 10'h285; memory[3755] = 10'h284; memory[3756] = 10'h284; memory[3757] = 10'h284; memory[3758] = 10'h283; memory[3759] = 10'h283;
    memory[3760] = 10'h282; memory[3761] = 10'h282; memory[3762] = 10'h282; memory[3763] = 10'h281; memory[3764] = 10'h281; memory[3765] = 10'h281; memory[3766] = 10'h280; memory[3767] = 10'h280; memory[3768] = 10'h27f; memory[3769] = 10'h27f;
    memory[3770] = 10'h27f; memory[3771] = 10'h27e; memory[3772] = 10'h27e; memory[3773] = 10'h27e; memory[3774] = 10'h27d; memory[3775] = 10'h27d; memory[3776] = 10'h27c; memory[3777] = 10'h27c; memory[3778] = 10'h27c; memory[3779] = 10'h27b;
    memory[3780] = 10'h27b; memory[3781] = 10'h27b; memory[3782] = 10'h27a; memory[3783] = 10'h27a; memory[3784] = 10'h279; memory[3785] = 10'h279; memory[3786] = 10'h279; memory[3787] = 10'h278; memory[3788] = 10'h278; memory[3789] = 10'h277;
    memory[3790] = 10'h277; memory[3791] = 10'h277; memory[3792] = 10'h276; memory[3793] = 10'h276; memory[3794] = 10'h276; memory[3795] = 10'h275; memory[3796] = 10'h275; memory[3797] = 10'h274; memory[3798] = 10'h274; memory[3799] = 10'h274;
    memory[3800] = 10'h273; memory[3801] = 10'h273; memory[3802] = 10'h272; memory[3803] = 10'h272; memory[3804] = 10'h272; memory[3805] = 10'h271; memory[3806] = 10'h271; memory[3807] = 10'h271; memory[3808] = 10'h270; memory[3809] = 10'h270;
    memory[3810] = 10'h26f; memory[3811] = 10'h26f; memory[3812] = 10'h26f; memory[3813] = 10'h26e; memory[3814] = 10'h26e; memory[3815] = 10'h26d; memory[3816] = 10'h26d; memory[3817] = 10'h26d; memory[3818] = 10'h26c; memory[3819] = 10'h26c;
    memory[3820] = 10'h26c; memory[3821] = 10'h26b; memory[3822] = 10'h26b; memory[3823] = 10'h26a; memory[3824] = 10'h26a; memory[3825] = 10'h26a; memory[3826] = 10'h269; memory[3827] = 10'h269; memory[3828] = 10'h269; memory[3829] = 10'h268;
    memory[3830] = 10'h268; memory[3831] = 10'h267; memory[3832] = 10'h267; memory[3833] = 10'h267; memory[3834] = 10'h266; memory[3835] = 10'h266; memory[3836] = 10'h265; memory[3837] = 10'h265; memory[3838] = 10'h265; memory[3839] = 10'h264;
    memory[3840] = 10'h264; memory[3841] = 10'h264; memory[3842] = 10'h263; memory[3843] = 10'h263; memory[3844] = 10'h262; memory[3845] = 10'h262; memory[3846] = 10'h262; memory[3847] = 10'h261; memory[3848] = 10'h261; memory[3849] = 10'h260;
    memory[3850] = 10'h260; memory[3851] = 10'h260; memory[3852] = 10'h25f; memory[3853] = 10'h25f; memory[3854] = 10'h25e; memory[3855] = 10'h25e; memory[3856] = 10'h25e; memory[3857] = 10'h25d; memory[3858] = 10'h25d; memory[3859] = 10'h25d;
    memory[3860] = 10'h25c; memory[3861] = 10'h25c; memory[3862] = 10'h25b; memory[3863] = 10'h25b; memory[3864] = 10'h25b; memory[3865] = 10'h25a; memory[3866] = 10'h25a; memory[3867] = 10'h259; memory[3868] = 10'h259; memory[3869] = 10'h259;
    memory[3870] = 10'h258; memory[3871] = 10'h258; memory[3872] = 10'h258; memory[3873] = 10'h257; memory[3874] = 10'h257; memory[3875] = 10'h256; memory[3876] = 10'h256; memory[3877] = 10'h256; memory[3878] = 10'h255; memory[3879] = 10'h255;
    memory[3880] = 10'h254; memory[3881] = 10'h254; memory[3882] = 10'h254; memory[3883] = 10'h253; memory[3884] = 10'h253; memory[3885] = 10'h252; memory[3886] = 10'h252; memory[3887] = 10'h252; memory[3888] = 10'h251; memory[3889] = 10'h251;
    memory[3890] = 10'h251; memory[3891] = 10'h250; memory[3892] = 10'h250; memory[3893] = 10'h24f; memory[3894] = 10'h24f; memory[3895] = 10'h24f; memory[3896] = 10'h24e; memory[3897] = 10'h24e; memory[3898] = 10'h24d; memory[3899] = 10'h24d;
    memory[3900] = 10'h24d; memory[3901] = 10'h24c; memory[3902] = 10'h24c; memory[3903] = 10'h24c; memory[3904] = 10'h24b; memory[3905] = 10'h24b; memory[3906] = 10'h24a; memory[3907] = 10'h24a; memory[3908] = 10'h24a; memory[3909] = 10'h249;
    memory[3910] = 10'h249; memory[3911] = 10'h248; memory[3912] = 10'h248; memory[3913] = 10'h248; memory[3914] = 10'h247; memory[3915] = 10'h247; memory[3916] = 10'h246; memory[3917] = 10'h246; memory[3918] = 10'h246; memory[3919] = 10'h245;
    memory[3920] = 10'h245; memory[3921] = 10'h245; memory[3922] = 10'h244; memory[3923] = 10'h244; memory[3924] = 10'h243; memory[3925] = 10'h243; memory[3926] = 10'h243; memory[3927] = 10'h242; memory[3928] = 10'h242; memory[3929] = 10'h241;
    memory[3930] = 10'h241; memory[3931] = 10'h241; memory[3932] = 10'h240; memory[3933] = 10'h240; memory[3934] = 10'h23f; memory[3935] = 10'h23f; memory[3936] = 10'h23f; memory[3937] = 10'h23e; memory[3938] = 10'h23e; memory[3939] = 10'h23e;
    memory[3940] = 10'h23d; memory[3941] = 10'h23d; memory[3942] = 10'h23c; memory[3943] = 10'h23c; memory[3944] = 10'h23c; memory[3945] = 10'h23b; memory[3946] = 10'h23b; memory[3947] = 10'h23a; memory[3948] = 10'h23a; memory[3949] = 10'h23a;
    memory[3950] = 10'h239; memory[3951] = 10'h239; memory[3952] = 10'h238; memory[3953] = 10'h238; memory[3954] = 10'h238; memory[3955] = 10'h237; memory[3956] = 10'h237; memory[3957] = 10'h236; memory[3958] = 10'h236; memory[3959] = 10'h236;
    memory[3960] = 10'h235; memory[3961] = 10'h235; memory[3962] = 10'h235; memory[3963] = 10'h234; memory[3964] = 10'h234; memory[3965] = 10'h233; memory[3966] = 10'h233; memory[3967] = 10'h233; memory[3968] = 10'h232; memory[3969] = 10'h232;
    memory[3970] = 10'h231; memory[3971] = 10'h231; memory[3972] = 10'h231; memory[3973] = 10'h230; memory[3974] = 10'h230; memory[3975] = 10'h22f; memory[3976] = 10'h22f; memory[3977] = 10'h22f; memory[3978] = 10'h22e; memory[3979] = 10'h22e;
    memory[3980] = 10'h22d; memory[3981] = 10'h22d; memory[3982] = 10'h22d; memory[3983] = 10'h22c; memory[3984] = 10'h22c; memory[3985] = 10'h22c; memory[3986] = 10'h22b; memory[3987] = 10'h22b; memory[3988] = 10'h22a; memory[3989] = 10'h22a;
    memory[3990] = 10'h22a; memory[3991] = 10'h229; memory[3992] = 10'h229; memory[3993] = 10'h228; memory[3994] = 10'h228; memory[3995] = 10'h228; memory[3996] = 10'h227; memory[3997] = 10'h227; memory[3998] = 10'h226; memory[3999] = 10'h226;
    memory[4000] = 10'h226; memory[4001] = 10'h225; memory[4002] = 10'h225; memory[4003] = 10'h224; memory[4004] = 10'h224; memory[4005] = 10'h224; memory[4006] = 10'h223; memory[4007] = 10'h223; memory[4008] = 10'h223; memory[4009] = 10'h222;
    memory[4010] = 10'h222; memory[4011] = 10'h221; memory[4012] = 10'h221; memory[4013] = 10'h221; memory[4014] = 10'h220; memory[4015] = 10'h220; memory[4016] = 10'h21f; memory[4017] = 10'h21f; memory[4018] = 10'h21f; memory[4019] = 10'h21e;
    memory[4020] = 10'h21e; memory[4021] = 10'h21d; memory[4022] = 10'h21d; memory[4023] = 10'h21d; memory[4024] = 10'h21c; memory[4025] = 10'h21c; memory[4026] = 10'h21b; memory[4027] = 10'h21b; memory[4028] = 10'h21b; memory[4029] = 10'h21a;
    memory[4030] = 10'h21a; memory[4031] = 10'h21a; memory[4032] = 10'h219; memory[4033] = 10'h219; memory[4034] = 10'h218; memory[4035] = 10'h218; memory[4036] = 10'h218; memory[4037] = 10'h217; memory[4038] = 10'h217; memory[4039] = 10'h216;
    memory[4040] = 10'h216; memory[4041] = 10'h216; memory[4042] = 10'h215; memory[4043] = 10'h215; memory[4044] = 10'h214; memory[4045] = 10'h214; memory[4046] = 10'h214; memory[4047] = 10'h213; memory[4048] = 10'h213; memory[4049] = 10'h212;
    memory[4050] = 10'h212; memory[4051] = 10'h212; memory[4052] = 10'h211; memory[4053] = 10'h211; memory[4054] = 10'h210; memory[4055] = 10'h210; memory[4056] = 10'h210; memory[4057] = 10'h20f; memory[4058] = 10'h20f; memory[4059] = 10'h20f;
    memory[4060] = 10'h20e; memory[4061] = 10'h20e; memory[4062] = 10'h20d; memory[4063] = 10'h20d; memory[4064] = 10'h20d; memory[4065] = 10'h20c; memory[4066] = 10'h20c; memory[4067] = 10'h20b; memory[4068] = 10'h20b; memory[4069] = 10'h20b;
    memory[4070] = 10'h20a; memory[4071] = 10'h20a; memory[4072] = 10'h209; memory[4073] = 10'h209; memory[4074] = 10'h209; memory[4075] = 10'h208; memory[4076] = 10'h208; memory[4077] = 10'h207; memory[4078] = 10'h207; memory[4079] = 10'h207;
    memory[4080] = 10'h206; memory[4081] = 10'h206; memory[4082] = 10'h205; memory[4083] = 10'h205; memory[4084] = 10'h205; memory[4085] = 10'h204; memory[4086] = 10'h204; memory[4087] = 10'h204; memory[4088] = 10'h203; memory[4089] = 10'h203;
    memory[4090] = 10'h202; memory[4091] = 10'h202; memory[4092] = 10'h202; memory[4093] = 10'h201; memory[4094] = 10'h201; memory[4095] = 10'h200; memory[4096] = 10'h200; memory[4097] = 10'h200; memory[4098] = 10'h1ff; memory[4099] = 10'h1ff;
    memory[4100] = 10'h1fe; memory[4101] = 10'h1fe; memory[4102] = 10'h1fe; memory[4103] = 10'h1fd; memory[4104] = 10'h1fd; memory[4105] = 10'h1fc; memory[4106] = 10'h1fc; memory[4107] = 10'h1fc; memory[4108] = 10'h1fb; memory[4109] = 10'h1fb;
    memory[4110] = 10'h1fb; memory[4111] = 10'h1fa; memory[4112] = 10'h1fa; memory[4113] = 10'h1f9; memory[4114] = 10'h1f9; memory[4115] = 10'h1f9; memory[4116] = 10'h1f8; memory[4117] = 10'h1f8; memory[4118] = 10'h1f7; memory[4119] = 10'h1f7;
    memory[4120] = 10'h1f7; memory[4121] = 10'h1f6; memory[4122] = 10'h1f6; memory[4123] = 10'h1f5; memory[4124] = 10'h1f5; memory[4125] = 10'h1f5; memory[4126] = 10'h1f4; memory[4127] = 10'h1f4; memory[4128] = 10'h1f3; memory[4129] = 10'h1f3;
    memory[4130] = 10'h1f3; memory[4131] = 10'h1f2; memory[4132] = 10'h1f2; memory[4133] = 10'h1f1; memory[4134] = 10'h1f1; memory[4135] = 10'h1f1; memory[4136] = 10'h1f0; memory[4137] = 10'h1f0; memory[4138] = 10'h1f0; memory[4139] = 10'h1ef;
    memory[4140] = 10'h1ef; memory[4141] = 10'h1ee; memory[4142] = 10'h1ee; memory[4143] = 10'h1ee; memory[4144] = 10'h1ed; memory[4145] = 10'h1ed; memory[4146] = 10'h1ec; memory[4147] = 10'h1ec; memory[4148] = 10'h1ec; memory[4149] = 10'h1eb;
    memory[4150] = 10'h1eb; memory[4151] = 10'h1ea; memory[4152] = 10'h1ea; memory[4153] = 10'h1ea; memory[4154] = 10'h1e9; memory[4155] = 10'h1e9; memory[4156] = 10'h1e8; memory[4157] = 10'h1e8; memory[4158] = 10'h1e8; memory[4159] = 10'h1e7;
    memory[4160] = 10'h1e7; memory[4161] = 10'h1e6; memory[4162] = 10'h1e6; memory[4163] = 10'h1e6; memory[4164] = 10'h1e5; memory[4165] = 10'h1e5; memory[4166] = 10'h1e5; memory[4167] = 10'h1e4; memory[4168] = 10'h1e4; memory[4169] = 10'h1e3;
    memory[4170] = 10'h1e3; memory[4171] = 10'h1e3; memory[4172] = 10'h1e2; memory[4173] = 10'h1e2; memory[4174] = 10'h1e1; memory[4175] = 10'h1e1; memory[4176] = 10'h1e1; memory[4177] = 10'h1e0; memory[4178] = 10'h1e0; memory[4179] = 10'h1df;
    memory[4180] = 10'h1df; memory[4181] = 10'h1df; memory[4182] = 10'h1de; memory[4183] = 10'h1de; memory[4184] = 10'h1dd; memory[4185] = 10'h1dd; memory[4186] = 10'h1dd; memory[4187] = 10'h1dc; memory[4188] = 10'h1dc; memory[4189] = 10'h1dc;
    memory[4190] = 10'h1db; memory[4191] = 10'h1db; memory[4192] = 10'h1da; memory[4193] = 10'h1da; memory[4194] = 10'h1da; memory[4195] = 10'h1d9; memory[4196] = 10'h1d9; memory[4197] = 10'h1d8; memory[4198] = 10'h1d8; memory[4199] = 10'h1d8;
    memory[4200] = 10'h1d7; memory[4201] = 10'h1d7; memory[4202] = 10'h1d6; memory[4203] = 10'h1d6; memory[4204] = 10'h1d6; memory[4205] = 10'h1d5; memory[4206] = 10'h1d5; memory[4207] = 10'h1d4; memory[4208] = 10'h1d4; memory[4209] = 10'h1d4;
    memory[4210] = 10'h1d3; memory[4211] = 10'h1d3; memory[4212] = 10'h1d3; memory[4213] = 10'h1d2; memory[4214] = 10'h1d2; memory[4215] = 10'h1d1; memory[4216] = 10'h1d1; memory[4217] = 10'h1d1; memory[4218] = 10'h1d0; memory[4219] = 10'h1d0;
    memory[4220] = 10'h1cf; memory[4221] = 10'h1cf; memory[4222] = 10'h1cf; memory[4223] = 10'h1ce; memory[4224] = 10'h1ce; memory[4225] = 10'h1cd; memory[4226] = 10'h1cd; memory[4227] = 10'h1cd; memory[4228] = 10'h1cc; memory[4229] = 10'h1cc;
    memory[4230] = 10'h1cb; memory[4231] = 10'h1cb; memory[4232] = 10'h1cb; memory[4233] = 10'h1ca; memory[4234] = 10'h1ca; memory[4235] = 10'h1ca; memory[4236] = 10'h1c9; memory[4237] = 10'h1c9; memory[4238] = 10'h1c8; memory[4239] = 10'h1c8;
    memory[4240] = 10'h1c8; memory[4241] = 10'h1c7; memory[4242] = 10'h1c7; memory[4243] = 10'h1c6; memory[4244] = 10'h1c6; memory[4245] = 10'h1c6; memory[4246] = 10'h1c5; memory[4247] = 10'h1c5; memory[4248] = 10'h1c4; memory[4249] = 10'h1c4;
    memory[4250] = 10'h1c4; memory[4251] = 10'h1c3; memory[4252] = 10'h1c3; memory[4253] = 10'h1c2; memory[4254] = 10'h1c2; memory[4255] = 10'h1c2; memory[4256] = 10'h1c1; memory[4257] = 10'h1c1; memory[4258] = 10'h1c1; memory[4259] = 10'h1c0;
    memory[4260] = 10'h1c0; memory[4261] = 10'h1bf; memory[4262] = 10'h1bf; memory[4263] = 10'h1bf; memory[4264] = 10'h1be; memory[4265] = 10'h1be; memory[4266] = 10'h1bd; memory[4267] = 10'h1bd; memory[4268] = 10'h1bd; memory[4269] = 10'h1bc;
    memory[4270] = 10'h1bc; memory[4271] = 10'h1bb; memory[4272] = 10'h1bb; memory[4273] = 10'h1bb; memory[4274] = 10'h1ba; memory[4275] = 10'h1ba; memory[4276] = 10'h1ba; memory[4277] = 10'h1b9; memory[4278] = 10'h1b9; memory[4279] = 10'h1b8;
    memory[4280] = 10'h1b8; memory[4281] = 10'h1b8; memory[4282] = 10'h1b7; memory[4283] = 10'h1b7; memory[4284] = 10'h1b6; memory[4285] = 10'h1b6; memory[4286] = 10'h1b6; memory[4287] = 10'h1b5; memory[4288] = 10'h1b5; memory[4289] = 10'h1b4;
    memory[4290] = 10'h1b4; memory[4291] = 10'h1b4; memory[4292] = 10'h1b3; memory[4293] = 10'h1b3; memory[4294] = 10'h1b3; memory[4295] = 10'h1b2; memory[4296] = 10'h1b2; memory[4297] = 10'h1b1; memory[4298] = 10'h1b1; memory[4299] = 10'h1b1;
    memory[4300] = 10'h1b0; memory[4301] = 10'h1b0; memory[4302] = 10'h1af; memory[4303] = 10'h1af; memory[4304] = 10'h1af; memory[4305] = 10'h1ae; memory[4306] = 10'h1ae; memory[4307] = 10'h1ae; memory[4308] = 10'h1ad; memory[4309] = 10'h1ad;
    memory[4310] = 10'h1ac; memory[4311] = 10'h1ac; memory[4312] = 10'h1ac; memory[4313] = 10'h1ab; memory[4314] = 10'h1ab; memory[4315] = 10'h1aa; memory[4316] = 10'h1aa; memory[4317] = 10'h1aa; memory[4318] = 10'h1a9; memory[4319] = 10'h1a9;
    memory[4320] = 10'h1a8; memory[4321] = 10'h1a8; memory[4322] = 10'h1a8; memory[4323] = 10'h1a7; memory[4324] = 10'h1a7; memory[4325] = 10'h1a7; memory[4326] = 10'h1a6; memory[4327] = 10'h1a6; memory[4328] = 10'h1a5; memory[4329] = 10'h1a5;
    memory[4330] = 10'h1a5; memory[4331] = 10'h1a4; memory[4332] = 10'h1a4; memory[4333] = 10'h1a3; memory[4334] = 10'h1a3; memory[4335] = 10'h1a3; memory[4336] = 10'h1a2; memory[4337] = 10'h1a2; memory[4338] = 10'h1a2; memory[4339] = 10'h1a1;
    memory[4340] = 10'h1a1; memory[4341] = 10'h1a0; memory[4342] = 10'h1a0; memory[4343] = 10'h1a0; memory[4344] = 10'h19f; memory[4345] = 10'h19f; memory[4346] = 10'h19e; memory[4347] = 10'h19e; memory[4348] = 10'h19e; memory[4349] = 10'h19d;
    memory[4350] = 10'h19d; memory[4351] = 10'h19c; memory[4352] = 10'h19c; memory[4353] = 10'h19c; memory[4354] = 10'h19b; memory[4355] = 10'h19b; memory[4356] = 10'h19b; memory[4357] = 10'h19a; memory[4358] = 10'h19a; memory[4359] = 10'h199;
    memory[4360] = 10'h199; memory[4361] = 10'h199; memory[4362] = 10'h198; memory[4363] = 10'h198; memory[4364] = 10'h197; memory[4365] = 10'h197; memory[4366] = 10'h197; memory[4367] = 10'h196; memory[4368] = 10'h196; memory[4369] = 10'h196;
    memory[4370] = 10'h195; memory[4371] = 10'h195; memory[4372] = 10'h194; memory[4373] = 10'h194; memory[4374] = 10'h194; memory[4375] = 10'h193; memory[4376] = 10'h193; memory[4377] = 10'h193; memory[4378] = 10'h192; memory[4379] = 10'h192;
    memory[4380] = 10'h191; memory[4381] = 10'h191; memory[4382] = 10'h191; memory[4383] = 10'h190; memory[4384] = 10'h190; memory[4385] = 10'h18f; memory[4386] = 10'h18f; memory[4387] = 10'h18f; memory[4388] = 10'h18e; memory[4389] = 10'h18e;
    memory[4390] = 10'h18e; memory[4391] = 10'h18d; memory[4392] = 10'h18d; memory[4393] = 10'h18c; memory[4394] = 10'h18c; memory[4395] = 10'h18c; memory[4396] = 10'h18b; memory[4397] = 10'h18b; memory[4398] = 10'h18a; memory[4399] = 10'h18a;
    memory[4400] = 10'h18a; memory[4401] = 10'h189; memory[4402] = 10'h189; memory[4403] = 10'h189; memory[4404] = 10'h188; memory[4405] = 10'h188; memory[4406] = 10'h187; memory[4407] = 10'h187; memory[4408] = 10'h187; memory[4409] = 10'h186;
    memory[4410] = 10'h186; memory[4411] = 10'h185; memory[4412] = 10'h185; memory[4413] = 10'h185; memory[4414] = 10'h184; memory[4415] = 10'h184; memory[4416] = 10'h184; memory[4417] = 10'h183; memory[4418] = 10'h183; memory[4419] = 10'h182;
    memory[4420] = 10'h182; memory[4421] = 10'h182; memory[4422] = 10'h181; memory[4423] = 10'h181; memory[4424] = 10'h181; memory[4425] = 10'h180; memory[4426] = 10'h180; memory[4427] = 10'h17f; memory[4428] = 10'h17f; memory[4429] = 10'h17f;
    memory[4430] = 10'h17e; memory[4431] = 10'h17e; memory[4432] = 10'h17e; memory[4433] = 10'h17d; memory[4434] = 10'h17d; memory[4435] = 10'h17c; memory[4436] = 10'h17c; memory[4437] = 10'h17c; memory[4438] = 10'h17b; memory[4439] = 10'h17b;
    memory[4440] = 10'h17a; memory[4441] = 10'h17a; memory[4442] = 10'h17a; memory[4443] = 10'h179; memory[4444] = 10'h179; memory[4445] = 10'h179; memory[4446] = 10'h178; memory[4447] = 10'h178; memory[4448] = 10'h177; memory[4449] = 10'h177;
    memory[4450] = 10'h177; memory[4451] = 10'h176; memory[4452] = 10'h176; memory[4453] = 10'h176; memory[4454] = 10'h175; memory[4455] = 10'h175; memory[4456] = 10'h174; memory[4457] = 10'h174; memory[4458] = 10'h174; memory[4459] = 10'h173;
    memory[4460] = 10'h173; memory[4461] = 10'h173; memory[4462] = 10'h172; memory[4463] = 10'h172; memory[4464] = 10'h171; memory[4465] = 10'h171; memory[4466] = 10'h171; memory[4467] = 10'h170; memory[4468] = 10'h170; memory[4469] = 10'h170;
    memory[4470] = 10'h16f; memory[4471] = 10'h16f; memory[4472] = 10'h16e; memory[4473] = 10'h16e; memory[4474] = 10'h16e; memory[4475] = 10'h16d; memory[4476] = 10'h16d; memory[4477] = 10'h16d; memory[4478] = 10'h16c; memory[4479] = 10'h16c;
    memory[4480] = 10'h16b; memory[4481] = 10'h16b; memory[4482] = 10'h16b; memory[4483] = 10'h16a; memory[4484] = 10'h16a; memory[4485] = 10'h169; memory[4486] = 10'h169; memory[4487] = 10'h169; memory[4488] = 10'h168; memory[4489] = 10'h168;
    memory[4490] = 10'h168; memory[4491] = 10'h167; memory[4492] = 10'h167; memory[4493] = 10'h166; memory[4494] = 10'h166; memory[4495] = 10'h166; memory[4496] = 10'h165; memory[4497] = 10'h165; memory[4498] = 10'h165; memory[4499] = 10'h164;
    memory[4500] = 10'h164; memory[4501] = 10'h164; memory[4502] = 10'h163; memory[4503] = 10'h163; memory[4504] = 10'h162; memory[4505] = 10'h162; memory[4506] = 10'h162; memory[4507] = 10'h161; memory[4508] = 10'h161; memory[4509] = 10'h161;
    memory[4510] = 10'h160; memory[4511] = 10'h160; memory[4512] = 10'h15f; memory[4513] = 10'h15f; memory[4514] = 10'h15f; memory[4515] = 10'h15e; memory[4516] = 10'h15e; memory[4517] = 10'h15e; memory[4518] = 10'h15d; memory[4519] = 10'h15d;
    memory[4520] = 10'h15c; memory[4521] = 10'h15c; memory[4522] = 10'h15c; memory[4523] = 10'h15b; memory[4524] = 10'h15b; memory[4525] = 10'h15b; memory[4526] = 10'h15a; memory[4527] = 10'h15a; memory[4528] = 10'h159; memory[4529] = 10'h159;
    memory[4530] = 10'h159; memory[4531] = 10'h158; memory[4532] = 10'h158; memory[4533] = 10'h158; memory[4534] = 10'h157; memory[4535] = 10'h157; memory[4536] = 10'h156; memory[4537] = 10'h156; memory[4538] = 10'h156; memory[4539] = 10'h155;
    memory[4540] = 10'h155; memory[4541] = 10'h155; memory[4542] = 10'h154; memory[4543] = 10'h154; memory[4544] = 10'h154; memory[4545] = 10'h153; memory[4546] = 10'h153; memory[4547] = 10'h152; memory[4548] = 10'h152; memory[4549] = 10'h152;
    memory[4550] = 10'h151; memory[4551] = 10'h151; memory[4552] = 10'h151; memory[4553] = 10'h150; memory[4554] = 10'h150; memory[4555] = 10'h14f; memory[4556] = 10'h14f; memory[4557] = 10'h14f; memory[4558] = 10'h14e; memory[4559] = 10'h14e;
    memory[4560] = 10'h14e; memory[4561] = 10'h14d; memory[4562] = 10'h14d; memory[4563] = 10'h14d; memory[4564] = 10'h14c; memory[4565] = 10'h14c; memory[4566] = 10'h14b; memory[4567] = 10'h14b; memory[4568] = 10'h14b; memory[4569] = 10'h14a;
    memory[4570] = 10'h14a; memory[4571] = 10'h14a; memory[4572] = 10'h149; memory[4573] = 10'h149; memory[4574] = 10'h148; memory[4575] = 10'h148; memory[4576] = 10'h148; memory[4577] = 10'h147; memory[4578] = 10'h147; memory[4579] = 10'h147;
    memory[4580] = 10'h146; memory[4581] = 10'h146; memory[4582] = 10'h146; memory[4583] = 10'h145; memory[4584] = 10'h145; memory[4585] = 10'h144; memory[4586] = 10'h144; memory[4587] = 10'h144; memory[4588] = 10'h143; memory[4589] = 10'h143;
    memory[4590] = 10'h143; memory[4591] = 10'h142; memory[4592] = 10'h142; memory[4593] = 10'h142; memory[4594] = 10'h141; memory[4595] = 10'h141; memory[4596] = 10'h140; memory[4597] = 10'h140; memory[4598] = 10'h140; memory[4599] = 10'h13f;
    memory[4600] = 10'h13f; memory[4601] = 10'h13f; memory[4602] = 10'h13e; memory[4603] = 10'h13e; memory[4604] = 10'h13e; memory[4605] = 10'h13d; memory[4606] = 10'h13d; memory[4607] = 10'h13c; memory[4608] = 10'h13c; memory[4609] = 10'h13c;
    memory[4610] = 10'h13b; memory[4611] = 10'h13b; memory[4612] = 10'h13b; memory[4613] = 10'h13a; memory[4614] = 10'h13a; memory[4615] = 10'h13a; memory[4616] = 10'h139; memory[4617] = 10'h139; memory[4618] = 10'h138; memory[4619] = 10'h138;
    memory[4620] = 10'h138; memory[4621] = 10'h137; memory[4622] = 10'h137; memory[4623] = 10'h137; memory[4624] = 10'h136; memory[4625] = 10'h136; memory[4626] = 10'h136; memory[4627] = 10'h135; memory[4628] = 10'h135; memory[4629] = 10'h134;
    memory[4630] = 10'h134; memory[4631] = 10'h134; memory[4632] = 10'h133; memory[4633] = 10'h133; memory[4634] = 10'h133; memory[4635] = 10'h132; memory[4636] = 10'h132; memory[4637] = 10'h132; memory[4638] = 10'h131; memory[4639] = 10'h131;
    memory[4640] = 10'h131; memory[4641] = 10'h130; memory[4642] = 10'h130; memory[4643] = 10'h12f; memory[4644] = 10'h12f; memory[4645] = 10'h12f; memory[4646] = 10'h12e; memory[4647] = 10'h12e; memory[4648] = 10'h12e; memory[4649] = 10'h12d;
    memory[4650] = 10'h12d; memory[4651] = 10'h12d; memory[4652] = 10'h12c; memory[4653] = 10'h12c; memory[4654] = 10'h12c; memory[4655] = 10'h12b; memory[4656] = 10'h12b; memory[4657] = 10'h12a; memory[4658] = 10'h12a; memory[4659] = 10'h12a;
    memory[4660] = 10'h129; memory[4661] = 10'h129; memory[4662] = 10'h129; memory[4663] = 10'h128; memory[4664] = 10'h128; memory[4665] = 10'h128; memory[4666] = 10'h127; memory[4667] = 10'h127; memory[4668] = 10'h127; memory[4669] = 10'h126;
    memory[4670] = 10'h126; memory[4671] = 10'h125; memory[4672] = 10'h125; memory[4673] = 10'h125; memory[4674] = 10'h124; memory[4675] = 10'h124; memory[4676] = 10'h124; memory[4677] = 10'h123; memory[4678] = 10'h123; memory[4679] = 10'h123;
    memory[4680] = 10'h122; memory[4681] = 10'h122; memory[4682] = 10'h122; memory[4683] = 10'h121; memory[4684] = 10'h121; memory[4685] = 10'h120; memory[4686] = 10'h120; memory[4687] = 10'h120; memory[4688] = 10'h11f; memory[4689] = 10'h11f;
    memory[4690] = 10'h11f; memory[4691] = 10'h11e; memory[4692] = 10'h11e; memory[4693] = 10'h11e; memory[4694] = 10'h11d; memory[4695] = 10'h11d; memory[4696] = 10'h11d; memory[4697] = 10'h11c; memory[4698] = 10'h11c; memory[4699] = 10'h11c;
    memory[4700] = 10'h11b; memory[4701] = 10'h11b; memory[4702] = 10'h11b; memory[4703] = 10'h11a; memory[4704] = 10'h11a; memory[4705] = 10'h119; memory[4706] = 10'h119; memory[4707] = 10'h119; memory[4708] = 10'h118; memory[4709] = 10'h118;
    memory[4710] = 10'h118; memory[4711] = 10'h117; memory[4712] = 10'h117; memory[4713] = 10'h117; memory[4714] = 10'h116; memory[4715] = 10'h116; memory[4716] = 10'h116; memory[4717] = 10'h115; memory[4718] = 10'h115; memory[4719] = 10'h115;
    memory[4720] = 10'h114; memory[4721] = 10'h114; memory[4722] = 10'h114; memory[4723] = 10'h113; memory[4724] = 10'h113; memory[4725] = 10'h112; memory[4726] = 10'h112; memory[4727] = 10'h112; memory[4728] = 10'h111; memory[4729] = 10'h111;
    memory[4730] = 10'h111; memory[4731] = 10'h110; memory[4732] = 10'h110; memory[4733] = 10'h110; memory[4734] = 10'h10f; memory[4735] = 10'h10f; memory[4736] = 10'h10f; memory[4737] = 10'h10e; memory[4738] = 10'h10e; memory[4739] = 10'h10e;
    memory[4740] = 10'h10d; memory[4741] = 10'h10d; memory[4742] = 10'h10d; memory[4743] = 10'h10c; memory[4744] = 10'h10c; memory[4745] = 10'h10c; memory[4746] = 10'h10b; memory[4747] = 10'h10b; memory[4748] = 10'h10a; memory[4749] = 10'h10a;
    memory[4750] = 10'h10a; memory[4751] = 10'h109; memory[4752] = 10'h109; memory[4753] = 10'h109; memory[4754] = 10'h108; memory[4755] = 10'h108; memory[4756] = 10'h108; memory[4757] = 10'h107; memory[4758] = 10'h107; memory[4759] = 10'h107;
    memory[4760] = 10'h106; memory[4761] = 10'h106; memory[4762] = 10'h106; memory[4763] = 10'h105; memory[4764] = 10'h105; memory[4765] = 10'h105; memory[4766] = 10'h104; memory[4767] = 10'h104; memory[4768] = 10'h104; memory[4769] = 10'h103;
    memory[4770] = 10'h103; memory[4771] = 10'h103; memory[4772] = 10'h102; memory[4773] = 10'h102; memory[4774] = 10'h102; memory[4775] = 10'h101; memory[4776] = 10'h101; memory[4777] = 10'h101; memory[4778] = 10'h100; memory[4779] = 10'h100;
    memory[4780] = 10'h100; memory[4781] = 10'h0ff; memory[4782] = 10'h0ff; memory[4783] = 10'h0ff; memory[4784] = 10'h0fe; memory[4785] = 10'h0fe; memory[4786] = 10'h0fe; memory[4787] = 10'h0fd; memory[4788] = 10'h0fd; memory[4789] = 10'h0fc;
    memory[4790] = 10'h0fc; memory[4791] = 10'h0fc; memory[4792] = 10'h0fb; memory[4793] = 10'h0fb; memory[4794] = 10'h0fb; memory[4795] = 10'h0fa; memory[4796] = 10'h0fa; memory[4797] = 10'h0fa; memory[4798] = 10'h0f9; memory[4799] = 10'h0f9;
    memory[4800] = 10'h0f9; memory[4801] = 10'h0f8; memory[4802] = 10'h0f8; memory[4803] = 10'h0f8; memory[4804] = 10'h0f7; memory[4805] = 10'h0f7; memory[4806] = 10'h0f7; memory[4807] = 10'h0f6; memory[4808] = 10'h0f6; memory[4809] = 10'h0f6;
    memory[4810] = 10'h0f5; memory[4811] = 10'h0f5; memory[4812] = 10'h0f5; memory[4813] = 10'h0f4; memory[4814] = 10'h0f4; memory[4815] = 10'h0f4; memory[4816] = 10'h0f3; memory[4817] = 10'h0f3; memory[4818] = 10'h0f3; memory[4819] = 10'h0f2;
    memory[4820] = 10'h0f2; memory[4821] = 10'h0f2; memory[4822] = 10'h0f1; memory[4823] = 10'h0f1; memory[4824] = 10'h0f1; memory[4825] = 10'h0f0; memory[4826] = 10'h0f0; memory[4827] = 10'h0f0; memory[4828] = 10'h0ef; memory[4829] = 10'h0ef;
    memory[4830] = 10'h0ef; memory[4831] = 10'h0ee; memory[4832] = 10'h0ee; memory[4833] = 10'h0ee; memory[4834] = 10'h0ed; memory[4835] = 10'h0ed; memory[4836] = 10'h0ed; memory[4837] = 10'h0ec; memory[4838] = 10'h0ec; memory[4839] = 10'h0ec;
    memory[4840] = 10'h0eb; memory[4841] = 10'h0eb; memory[4842] = 10'h0eb; memory[4843] = 10'h0ea; memory[4844] = 10'h0ea; memory[4845] = 10'h0ea; memory[4846] = 10'h0e9; memory[4847] = 10'h0e9; memory[4848] = 10'h0e9; memory[4849] = 10'h0e8;
    memory[4850] = 10'h0e8; memory[4851] = 10'h0e8; memory[4852] = 10'h0e7; memory[4853] = 10'h0e7; memory[4854] = 10'h0e7; memory[4855] = 10'h0e6; memory[4856] = 10'h0e6; memory[4857] = 10'h0e6; memory[4858] = 10'h0e6; memory[4859] = 10'h0e5;
    memory[4860] = 10'h0e5; memory[4861] = 10'h0e5; memory[4862] = 10'h0e4; memory[4863] = 10'h0e4; memory[4864] = 10'h0e4; memory[4865] = 10'h0e3; memory[4866] = 10'h0e3; memory[4867] = 10'h0e3; memory[4868] = 10'h0e2; memory[4869] = 10'h0e2;
    memory[4870] = 10'h0e2; memory[4871] = 10'h0e1; memory[4872] = 10'h0e1; memory[4873] = 10'h0e1; memory[4874] = 10'h0e0; memory[4875] = 10'h0e0; memory[4876] = 10'h0e0; memory[4877] = 10'h0df; memory[4878] = 10'h0df; memory[4879] = 10'h0df;
    memory[4880] = 10'h0de; memory[4881] = 10'h0de; memory[4882] = 10'h0de; memory[4883] = 10'h0dd; memory[4884] = 10'h0dd; memory[4885] = 10'h0dd; memory[4886] = 10'h0dc; memory[4887] = 10'h0dc; memory[4888] = 10'h0dc; memory[4889] = 10'h0db;
    memory[4890] = 10'h0db; memory[4891] = 10'h0db; memory[4892] = 10'h0da; memory[4893] = 10'h0da; memory[4894] = 10'h0da; memory[4895] = 10'h0da; memory[4896] = 10'h0d9; memory[4897] = 10'h0d9; memory[4898] = 10'h0d9; memory[4899] = 10'h0d8;
    memory[4900] = 10'h0d8; memory[4901] = 10'h0d8; memory[4902] = 10'h0d7; memory[4903] = 10'h0d7; memory[4904] = 10'h0d7; memory[4905] = 10'h0d6; memory[4906] = 10'h0d6; memory[4907] = 10'h0d6; memory[4908] = 10'h0d5; memory[4909] = 10'h0d5;
    memory[4910] = 10'h0d5; memory[4911] = 10'h0d4; memory[4912] = 10'h0d4; memory[4913] = 10'h0d4; memory[4914] = 10'h0d3; memory[4915] = 10'h0d3; memory[4916] = 10'h0d3; memory[4917] = 10'h0d2; memory[4918] = 10'h0d2; memory[4919] = 10'h0d2;
    memory[4920] = 10'h0d2; memory[4921] = 10'h0d1; memory[4922] = 10'h0d1; memory[4923] = 10'h0d1; memory[4924] = 10'h0d0; memory[4925] = 10'h0d0; memory[4926] = 10'h0d0; memory[4927] = 10'h0cf; memory[4928] = 10'h0cf; memory[4929] = 10'h0cf;
    memory[4930] = 10'h0ce; memory[4931] = 10'h0ce; memory[4932] = 10'h0ce; memory[4933] = 10'h0cd; memory[4934] = 10'h0cd; memory[4935] = 10'h0cd; memory[4936] = 10'h0cc; memory[4937] = 10'h0cc; memory[4938] = 10'h0cc; memory[4939] = 10'h0cc;
    memory[4940] = 10'h0cb; memory[4941] = 10'h0cb; memory[4942] = 10'h0cb; memory[4943] = 10'h0ca; memory[4944] = 10'h0ca; memory[4945] = 10'h0ca; memory[4946] = 10'h0c9; memory[4947] = 10'h0c9; memory[4948] = 10'h0c9; memory[4949] = 10'h0c8;
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
